vbartusevicius/knx-dali-gateway/hardware/releases/v3/README.md

# KNX-DALI gateway hardware v3 (1 DIN, two boards)

**Revision D (2026-10-22).** Changes against rev C (`59eea1f`, the first order): AUX-powered core (TRACO TMR 1-2411 U9 isolated converter, hand-fitted, plus TI TPS2121 U10 priority mux with the KNX buck as fallback); XIAO LM66100 U7 CE on VOUT (no USB back-feed); DALI TX clamp 2R, gate divider 4k7/10k, RX pull-up 4k7, buck EN 100k; enclosure with channels over the back-side diodes, board edge reliefs, backing ribs, C-shaped spring button tabs with front bumps and plungers, OLED supports beside the panel, longer DALI terminal slot; through-hole leads trimmed to 1.5 mm; a base right-wall recess over U9. Rev C boards and prints: follow [`hardware/docs/rework-rev-c.md`](../../docs/rework-rev-c.md) (pins in `rework/`). NCN5130 cluster re-placed to the datasheet layout rules (C1/C2/C3/C5/C15, L1).

**Hand-assembly revision (2026-11-11).** Every part is chosen for soldering with an iron:
- **Passives:** all 0805 or larger. The one exception is v3's three NCN5130 bus caps (C1 47 nF, C2 100 nF, C3 220 nF), which are 0603 so the chip's left side stays routable.
- **LEDs:** WS2812B-MINI-V3J with gull-wing legs (LCSC C22371519).
- **Crystal:** 2-pad 5032.
- **Core power path:** leaded parts (TLV803M U10, 2N7002 Q10, AO3401A Q9, B5819W D11) replace the VQFN TPS2121.
- **Still fine-pitch:** the NCN5130 (QFN-40; no leaded KNX transceiver exists: hot plate or hot air) and the LM66100 (SC-70-6, leaded).
- **Isolation:** DALI isolation is 5.5 mm (reinforced, IEC 60664-1 230 V OVC III PD2); SELV-AUX to SELV-KNX is 1 mm (functional).
- **Buttons:** left = SCROLL (plain bump), right = RESET (X bump).
- **USB service:** the XIAO is turned so its USB-C faces the main board's rail-side edge (x 38.1, 1.7 mm from the edge, nothing tall in the path). Lift main out of the base to plug in: with the board in the base the plug overmould does not fit under the right wall. test_usb_access.py keeps the plug path clear.
- `<board>/<board>_assembly.pdf`: hand-soldering guide. One page per populated side (the bottom mirrored, as seen from below), each part's body, reference and value, a red dot on pin 1, a black corner on hand-fitted parts and one colour per value. Large parts are dashed under the small ones. A values page lists quantity, side and references.

Generated by `HARDWARE_VARIANT=v3 python3 hardware/scripts/release.py v3` from
`hardware/layout/v3/`, with the same gates as v2: KiCad DRC 0 errors and 0
unrouted, every part orderable or hand-fit, every JLC part checked against
JLCPCB's part record, live stock and its EasyEDA footprint (pin for pin; the
placement file carries the fitted rotations and centres). CI
(`HARDWARE_VARIANT=v3`, `test_release_current.py`) fails as soon as either board
no longer matches this release.

| Board | Size | Layers | Thickness | Position in the case | Folder |
|---|---|---|---|---|---|
| **Breakaway Panel (`panel`)** | **55.6 x 78.0 mm** | **4** | **1.2 mm** | **Combined `main` + `ui` on one PCB with mouse-bite breakaway tabs (1 PCB + 1 PCBA order)** | **`panel/`** |
| Main (`main`) | 39.8 x 78.0 mm | 4 | 1.2 mm | vertical along the left side wall (two-sided): tall parts on the front (+x: KNX/AUX/DALI push-in pin strips, 470 uF SMD cap, 220 uH inductor, XIAO on 5 mm sockets with 5 V buck underneath, REC3-2415SRW/H2/A/CTRL, JP1, DALI bridge/pass transistor/optocouplers, UI FFC), low SMD parts on the back (-x, inside the THT solder-tail shadow: NCN5130 + crystal + passives, DALI TX/RX passives & transistors) | `main/` |
| UI (`ui`) | 13.8 x 40.5 mm | 4 | 1.2 mm | snapped into the cover protrusion: 0.96" 64x128 portrait SSD1312 OLED (QG-6428TSWCG02 / JLX12864OLED-S096W / NFP1312-15AY, 14.0 x 28.0 mm) soldered to the 14-pad 0.62 mm pitch footprint on the back with 3.3 V charge-pump passives, two Omron B3U-1000P buttons with 1.4 mm protruding caps, three RGB LEDs in a row below the buttons, 8-pin FFC to main | `ui/` |

A single 8-pin 0.5 mm **Type B (reverse / opposite-side contacts)** FFC cable (`SHOU HAN FFC-0.5-8P-50mm-B`, LCSC `C42416274`, 50 mm) connects `main` J4 to `ui` J1 (since both `J4` and `J1` are bottom-contact FFC connectors with Pin 1 on the same side, a Type B reverse cable connects Pin 1 `+3V3` to Pin 1 `+3V3`).

## Ordering at JLCPCB

1. **Recommended — Order as 1 Breakaway Panel (`panel/`):**
   - Upload `panel/panel_gerbers.zip` and select **4 layers, `1.2 mm` PCB Thickness** on JLCPCB's order page (note: JLCPCB's web form always defaults the thickness radio button to `1.6 mm` until you click **`1.2`**).
   - Enable **PCB Assembly (Both Sides)** and upload `panel/panel_bom_jlc.csv` + `panel/panel_cpl_jlc.csv`.
2. **Or Order as Separate Boards (`main/` and `ui/`):**
   - Upload `main/main_gerbers.zip` and `ui/ui_gerbers.zip` (4 layers, **1.2 mm**).
   - Upload `<board>_bom_jlc.csv` + `<board>_cpl_jlc.csv`.
3. `<board>_assembly_check.csv` (and `panel/panel_assembly_check.csv`) lists JLCPCB footprint, rotation and stock for
   every part.

## Ordering elsewhere (Aisler, PCBWay, Eurocircuits, ...)

Each board folder and `panel/` also holds fab-independent files:

- `<board>_odb.zip`: ODB++ (copper, drills, outline, netlist, component
  placement). Aisler's preferred upload; PCBWay and Eurocircuits accept it.
- `<board>_gerbers.zip`: Gerber X2 per layer, Excellon drills (plated and
  non-plated) and `<board>.d356`, the IPC-D-356 netlist for the electrical test.
- `<board>_bom.csv`: every part with value, footprint, manufacturer part number
  (LCSC number for reference), SMD/THT, and whether the assembler or you fit it.
- `<board>_cpl.csv`: placement of the assembled parts in KiCad's coordinates
  and rotations (the `_jlc` files use JLCPCB's rotations and are for JLCPCB only).

Order the stack-up, thickness and finish given above; check the assembler's
placement preview for the bottom-side and rotated parts as for JLCPCB.

## Ordering the parts yourself

For one complete gateway (all boards and hand-fit parts), in this folder:

- `order_lcsc.csv`: LCSC BOM tool (lcsc.com → BOM Tool, map **LCSC Part Number** and
  **Quantity**). Every board part plus the hand-fit parts LCSC sells; one line per LCSC number,
  designators as `board:ref`. Multiply the quantities for more gateways; LCSC rounds up to each
  part's minimum order.
- `order_elsewhere.csv`: the electronics LCSC does not sell (XIAO, REC3, converters, Phoenix pin
  strips and plugs, OLED, cable), with every Mouser / Digi-Key / TME number. A cell may list
  alternatives, e.g. `713-102010636 (or 713-113991254)`; buy one of them.
- `assembly_parts.csv`: everything not placed by the assembler, with a **Kind** column:
  `electronics` (the hand-fit parts above), `utility` (screws, foam pad, lead trimming) and
  `printed` (case parts). Utility and printed items are not in the order files; get them locally.

Not needed when JLCPCB assembles the boards: then order only the hand-fit lines.

## Hand-fitted parts (`<board>_hand_fit.csv`)

- `main` J1, J2: two **Phoenix Contact 1574200** (PST 1,0/2-5,75) pin strips on
  the bottom shoulder of `main` (pins pointing +x to the right). The red/black KNX
  plug (front) and the yellow/grey 20-32 V AUX plug (rear) go in from the right
  side into pockets sized for the WAGO 243-211 (11.5 x 10.2 x 10.2 mm, measured,
  0.3 mm clearance all round, a slot for the butterfly key on the lower wall)
  and sit on the strips, where their sockets meet the pins. Their wire entries
  face down, about 2.8 mm inside the open bottom of the pockets. With the
  11.5 mm plug, about 1 mm of it stands out of the case's right side: leave
  that gap to the next device on the rail.
- `main` J3: **WAGO 2086-1202/700-000/997-604**, the 2-pole 3.5 mm SMD DALI
  push-in terminal. Hand-solder it (JLCPCB has none in stock; Digi-Key
  `2946-2086-1202/700-000/997-604CT-ND`). Its wire entries and both release
  buttons are in the face that sits in the top-wall opening: press a button
  with a 2-2.5 mm flat screwdriver to release a wire. Strip 8-9 mm,
  0.14-1.5 mm2. Rated 160 V (overvoltage cat. III) / 320 V (cat. II): fine for
  DALI, not for a 230 V circuit.
- `main` U3: RECOM **REC3-2415SRW/H2/A/CTRL** (or **REC3-2415SRW/H4/A/M/CTRL**, DIP-24, A pinning with pin 1 CTRL; clip unused pins 3 and 11 flush before soldering; or Mean Well **SCWN06B-15** / **SCW03B-15** if software PSU shut-off is not needed).
- `main` U8: Seeed **XIAO ESP32C6 Pre-Soldered (SKU 102010636)** in two 1x7
  5.0 mm female headers (`assembly_parts.csv`).

Legend (3 mm letters, 0.6 mm deep, so a powder print keeps them):
- Right side of the base, next to the connectors: `KNX` above the front plug
  pocket, `AUX` above the rear one, `DALI` level with the DALI terminal at the
  top. They are engraved into `base.stl`, so every print has them.
- Front: no text. The left button (SCROLL: page / hold 5 s WiFi setup) has a
  plain round bump, the right one (RESET: tap reboot / hold 5 s KNX
  programming mode) has an X recessed 0.35 mm into its bump; both held 10 s
  is a factory reset. The three LEDs are unmarked; from left to right they are
  STATUS, KNX and DALI. There is no `cover_embossed.stl` on v3.

Off-board parts (including the **0.96" 64x128 SSD1312** 14-pin `0.62 mm`-pitch
OLED `QG-6428TSWCG02` / `NFP1312-15AY`, whose `12.0 mm` flex tail folds through
the `9.8 mm` top notch on `ui` and solders onto `ui` J2) are in `assembly_parts.csv`.
