vbartusevicius/knx-dali-gateway/hardware/docs/review-2026-10-23.md

# Pre-manufacturing review, 2026-10-23

Scope: v2 rev C and v3 rev D at `f3ccb1e`. That is the state after the 2026-10-22 review: AUX core
supply (U9 TMR 1-2411, U10 TPS2121) and the rev D NCN5130 placement. Nothing from these sources has
been ordered yet. Boards and prints already made from `59eea1f` are covered by
[rework-rev-c.md](rework-rev-c.md). No finding below adds a rework step for them (see the last section).

Status: **fixed** = changed in the sources; **open** = not fixed yet. Where possible it is pinned by a
strict-xfail test that fails as soon as the fix lands, so the marker has to be removed;
**accepted** = known and tolerated; **bench** = only a measurement can settle it.

## Automated checks

| Check | v2 | v3 |
|---|---|---|
| `build.py --eda` (netlists, sync, routing check, renders) | pass | pass |
| `build.py --cad` (enclosure, fit, legend, renders) | pass | pass |
| EDA suite (`hardware/tests`, `test_fit`, `test_ui_stackup`, `test_board_stack`) | 186 passed, 2 skipped | 163 passed, 4 skipped |
| CAD suite (`test_enclosure_probe`, `test_enclosure_solids`, `test_front_legend`, `test_step_geometry`) | 49 passed, 1 skipped | 43 passed, 5 skipped |
| `ruff` lint | pass | pass |
| DRC errors / unrouted | 0 / 0 | 0 / 0 |

The skips are by design (no AUX copper on the interface board; the v3 pad has no thermal vias, L2; the
v3 legend has no bracket).

Running `build.py --eda` on unchanged sources rewrote every stored `.kicad_pcb`. Footprints, positions,
tracks, vias and zones were identical; only UUIDs and order changed. `test_release_current` then
failed against the committed release (R1 below). The suites above ran on the committed layouts.

## Electrical

| # | Finding | Evidence | Status |
|---|---|---|---|
| E12 | **The core rail can collapse during the TPS2121 switchover.** CP2 is grounded, so the mux runs in plain priority mode. The guaranteed switchover time is then tSW = 100 µs max; the 5 µs fast switchover (tFSW) needs CP2 ≥ VREF. A WiFi TX peak needs about 298 mA at 5 V: 354 mA chip at 21 dBm, plus OLED and optos, through the 88 % XIAO buck, plus LEDs. That is above the TMR 1's 240 mA minimum current limit, and its overload mode is foldback. So TX bursts drag AUX below the PR1 threshold (3.9 V worst case) and hand over to KNX. AUX unplugged during a burst does the same. The derated 10 µF ceramics on +5V/+5V_XIAO then fall to about 1.1 V within 100 µs, so the ESP32-C6 browns out. The 2026-10-22 note "switches within microseconds" holds only with CP2 ≥ VREF. AUX-only operation (KNX bus down) cannot carry TX peaks at all with a 1 W converter. | TPS2121 SLVSEA3F §7.5 tSW/tFSW, §9.3.7, table 9-3; TMR 1 datasheet p.2 (current limit 120 % min, foldback); ESP32-C6 datasheet v1.5 table 5-7; `test_circuit_physics::test_core_rail_rides_through_the_mux_switchover` (strict xfail; with `--runxfail`: 1.12 V) | TX peaks fixed: v3 TMR 2411, v2 TRN 3-2411 (follow-ups below). AUX hot-unplug during TX still open (C23 100 µF: 3.08 V worst case) |
| E13 | **TX active half-bits are stretched by about 38 µs (typical).** The TX opto runs saturated: 6 mA LED, about 1 mA collector. The TLP383 turn-off at IF 16 mA / RL 1.9 kΩ is 28 µs typical, and the gate discharge adds about 10 µs. The transmitter window allows +16 µs (433 − 417). The existing `test_tx_gate_turns_off_within_the_half_bit_tolerance` passes only because it gives the opto an unverified 4 µs share. Firmware has no edge trim. | TLP383 datasheet (2019-12-16) table 10; `Timing.hpp` tx_half 400–433; `test_tx_active_half_bit_stays_inside_the_transmitter_window` (strict xfail; 38 µs) | open: firmware trim of active half-bits in the RMT encoder (about 20–35 µs, set from the bench measurement); then set `FIRMWARE_TX_ACTIVE_TRIM_S` and remove the marker |
| E14 | **Losing KNX switches the internal DALI supply off, even when AUX powers the core.** SAVEB is pulled up to `+3V3_TRX`, the NCN's own rail. With KNX absent it reads low; the ESP pull-up only reaches about 0.6 V against 10 kΩ to 0 V. `KnxDevice::update_led` then calls `NetworkServices::emergency_power_down()`, which sets `DALI_SUPPLY_OFF` high and skips `DaliPsuMonitor` (short detection) completely. With the AUX core this turns a KNX bus outage into a DALI outage, against the "DALI continues" requirement. Even in KNX-only operation it gains nothing: the REC3 runs from AUX, and the supply-off opto LED adds 6.4 mA to the dying 3.3 V rail. Hardware cannot make SAVEB read high with the NCN unpowered (its pin clamps to its VDD). | `knx.py` (R SAVEB to +3V3_TRX); `KnxDevice.cpp:194-212`; `NetworkServices.cpp:881-884` | open (firmware): on SAVEB low only log and flush; keep the PSU monitor and the supply state |
| E15 | With KNX absent and AUX present (new with the AUX core), the idle-high UART TX (GPIO16) feeds the unpowered NCN5130 SDI clamp through the 1 kΩ (up to about 2.7 mA), together with the SAVEB pull-up. `+3V3_TRX` is partly back-powered. The NCN power-on reset when the bus returns is then not specified. KNX_TXD (NCN SDO) floats into the UART RX. | `knx.py` R KNX_RXD 1k; NCN5130 has no Ioff spec | open (firmware): with SAVEB low, set GPIO16 to input or low and ignore UART RX; bench: measure `+3V3_TRX` and the NCN restart |
| E8 | (update) The sustained-short risk with the MCU unpowered is now reduced. With AUX present the TMR 1 powers the MCU, so `DaliPsuMonitor` can run whenever the REC3 runs. Today, though, it is disabled exactly when KNX is absent (E14). | — | open until E14 is fixed; hardware foldback no longer the only option |
| E16 | DALI RX threshold. Worst case, the "bus high" detection needs Vz 5.88 + VF 1.4 + limiter 0.95 + bridge 1.4 ≈ 9.6 V. That uses the test's conservative CTR 1.0, which forces the LED to the 0.81 mA limit. The spec point is 9.5 V. With typical values about 8.5 V. The low side is fine: at 6.5 V the zener sees about 3.7 V, so there is no LED current. | MMSZ5V6 ±5 % at 5 mA; TLP383 VF 1.1–1.4 V at 10 mA | bench: sweep the bus 6–10 V and record the switching point |
| E17 | REC3 load during DALI transmission. The internal limiter allows 167–227 mA, above the REC3's 200 mA rating, during every active low. Its overload behaviour at 227 mA (SCP, auto recovery) is not documented as a number. | `test_tx_clamp_lets_the_bus_supply_set_the_low_level` (limiter max) | bench: watch the 15 V rail during a long frame and a 1.3 ms collision break |

### Fix proposal for E12 (needs a layout change on both variants)

1. **Fast switchover (XREF).** CP2 gets a divider from `+5V_BUCK`: R27 30k / R28 10k gives 1.20–1.27 V, which is ≥ VREF 1.10 max and enables tFSW = 5 µs. Change R24 from 30k to 24k: PR1 is then ≥ 1.41 V at AUX 4.95 V, above CP2. Behaviour: AUX hands over below about 4.1–4.3 V. With KNX absent, CP2 = 0 and PR1 is above VREF, so IN1 (AUX) is selected. With AUX absent, IN2 (KNX) is selected. With this alone the test computes a 3.75 V minimum (pass).
2. **Bulk on the mux output.** C23 10 µF/0603 → 47–100 µF (1206 X5R, or polymer). This gives margin for the repeated handovers during TX bursts (TMR foldback/recovery chatter). The TMR 1 allows 1680 µF.
3. **Source status.** TPS2121 ST is open drain, high = IN1. Connect it to the spare D3/GPIO21 with a 10k pull-up to 3V3, instead of GND. Firmware can then pick `wifi_power_save`: continuous on AUX, modem sleep on KNX (E6). It can also tell a KNX outage from imminent core loss (E14).
4. **AUX-only with WiFi.** Option a: TMR 2411 (2 W, 400 mA, SIP-8 21.8 × 9.1 × 11.2 mm, 1000 µF max load); this needs new placement in both cases. Option b: limit the WiFi TX power in firmware while ST reports AUX without KNX, then measure. User decision.

New parts get new fixed references (R27, R28), so nothing renumbers. Freerouting is chaotic: expect re-placement around U10 (AGENTS.md).

### Follow-up (user decision, same day): 2 W converter on v3 instead of the switching change

The user chose option 4a over items 1–3 for v3: a 2 W converter that carries the WiFi TX peaks itself,
in the free space of the front protrusion between the main board edge and the UI board.

- **Part:** U9 is now a TRACO TMR 2411. Ratings: 18–36 V in, 5 V, 400 mA, 1.6 kVDC functional, 1000 µF max load, Remote pin 3 left open (= on). Package SIP-8, 21.8 × 9.1 × 11.2 mm. Stock: Mouser 495-TMR-2411 (447 pcs, USD 15), Digi-Key 1951-2741-ND (1241 pcs, USD 17.24). The TMR 3-2411 (3 W, 600 mA) uses the same package and pins.
- **Footprint:** `Converter_DCDC_TRACO_TMR2_SIP8`. The outline puts the pin row 3.5 mm from one long face and 5.6 mm from the other, but does not say which face is marked. Fab and courtyard therefore cover 5.6 mm on both sides, and the placement fits either orientation.
- **Physics:** 298 mA TX peak at 5 V against 400 mA. New test `test_aux_converter_carries_the_wifi_tx_peak` passes on v3; it is a strict xfail on v2, which keeps the TMR 1-2411.
- **Layout, v3 main:**
  - The board gets a tongue: outline x −10.3…0, y 18.3…59.7. It reaches enclosure z 52.2, which is 0.2 mm inside the protrusion walls and 0.5 mm behind the UI board's parts.
  - U9 stands on the tongue's upper half, pin 1 at the top, pin row at x −4.55. Its body (x −10.15…1.05) stays clear of the UI board's FFC exit above UI J1.
  - An AUX corridor brings AUX_P/GNDA to U9: along the bottom edge (y < 3.4), up the front edge (x < 1.5), across the tongue's bottom and along its outer edge. 2 mm keep-outs separate it from SELV-KNX.
  - U9's output pins (6/7) connect down into the KNX zone.
  - A 6 mm keep-out (x −3.8…2.4, y 42…63.5) separates the tongue copper from DALI.
  - To clear these keep-outs: D1/D2 moved to x 7.1; Q1 moved +1.4 mm; D8, R16, R17, Q3, R18, C18 and D9 moved +0.4…1.5 mm. The old rear-bottom U9 corner is empty.
  - Freerouting: 0 unrouted, DRC 0. Isolation tests pass on the routed copper.
- **Enclosure:** U9's top (11.7 mm max) reaches x 7.5. A new `protrusion_part_reliefs()` cuts a 0.4 mm channel in the cover's right protrusion wall, open towards the base. The base's right wall and the cover lips get local recesses (existing code). The body ends 0.34 mm below the UI snap hook and 0.9 mm behind the UI parts. All solid, probe and fit tests pass.
- **Still open:** with CP2 grounded, unplugging AUX during a TX burst still takes up to 100 µs to switch over (`test_core_rail_rides_through_the_mux_switchover` stays a strict xfail).

### Follow-up 2 (same day): v3 tongue cut back, C23, v2 converter

- **v3 tongue:** below U9 only a 1.4 mm strip remains (outline x −1.4…0, y 18.3…37.3), which frees the protrusion under U9 for the UI cable. The AUX corridor now runs up that strip and along the tongue's lower edge (y 37.6–38.4) to its outer edge. 2 mm keep-outs: x 0…1.7 beside the strip, y 38.4…40.4 above the lower edge. To clear them: C4 turned 90° (VFILT pad from x 0.8 to 5.6), L1 +0.8 mm in y, C7 +0.1 mm, R14 moved to (4.4, 36.9), C21 to the back at (1.5, 41.0). NCN5130 layout rules, isolation, DRC 0 / unrouted 0.
- **C23:** 100 µF 6.3 V X5R 1206 (Samsung CL31A107MQHNNNE, LCSC C15008, basic part, 1.9 M in stock) on both variants. With about 30 % of the capacitance left at 5 V (series curve estimate), the worst case (AUX lost at a 298 mA TX peak, 100 µs switchover) dips to 3.08 V, against 1.12 V with 10 µF. The 3.5 V target is still missed, so the test stays a strict xfail. At the continuous-RX load (115 mA) the dip is about 0.3 V.
- **v2 converter:** the TMR 2411 does not fit v2.
  - The 7.7 mm strip on the back is too narrow for its 9.1 mm body.
  - Under the interface board there is 11.0 mm, against an 11.7 mm maximum height.
  - The free-looking top area on the front sits over the REC3 (U3, back, y 38–70), so through-hole pins there would land on its body. It is also SELV-AUX/DALI copper, far from the KNX zone that the output must reach.

  U9 on v2 is therefore a TRACO **TRN 3-2411** (3 W, 5 V 600 mA, 18–36 V, 1.6 kVDC functional, current limit 180 % typ, 2200 µF max load). Its SIP is 11.9 × 7.7 × 11.0 mm with pins 1 −Vin, 2 +Vin, 3 +Vout, 5 −Vout. It stands in the old strip on the back (pin row y 33.6), with Fab/courtyard covering 4.0 mm on both sides of the pin row. Pins 2 (AUX) and 3 (KNX) are only 2.8 mm apart, so the AUX tracks leave upwards and the KNX tracks downwards. A 1.0 × 3.0 mm board slot between those pins lengthens the creepage path past 2 mm. Stock: Newark 47AC2160 (37), LCSC C5987491 (9), about USD 22, 24-week factory lead time. Check stock before ordering.
- **Tooling bug found (fixed):** the generated DRC rules tried to exempt an isolator's own pins with `A.Reference == 'Ux'`. KiCad evaluates creepage per net pair, so no item condition (`Reference`, `memberOfFootprint`) ever matches, and the exemption never worked. Previous boards never needed it. `layout.dru_rules` no longer pretends to exempt anything. `test_drc_creepage::test_slot_between_isolator_pins_meets_creepage` shows that a slot clears the violation and a rule cannot. `test_isolation.py` keeps its own same-isolator exemption.

## Datasheet cross-checks (parts changed since `59eea1f`)

| Part | Checked | Result |
|---|---|---|
| U9 TRACO TMR 1-2411 | Datasheet rev. 2026-04-15 p.1–4 | 18–36 V, 5 V ±1 %, 200 mA, UVLO 17.5 V max, surge 50 V/1 s, 1680 µF max load, no minimum load, current limit 120 % min with foldback, functional isolation 1.5 kVDC/60 s. Pinout 1 −Vin, 2 +Vin, 4 +Vout, 6 −Vout matches `pinouts.yaml` and the footprint. Pin 1 is 2.15 mm from the end and the pin row 2.5 mm from the back face. From the projection, the marked face is 5.12 mm from the pin row, which matches the footprint's +y side. Body 17.0 × 7.62 × 11.0 (±0.5) and pins 3.2 match `package_heights.yaml` (11.5 / 3.7). Its 0.3 W loss is fine in the case. |
| U10 TI TPS2121RUXR | SLVSEA3F | Pin map 1/8 OUT, 2 IN2, 3 CP2, 4 OV2, 5 OV1, 6 PR1, 7 IN1, 9 ST, 10 ILM, 11 SS, 12 GND matches the netlist. ST/OV1/OV2/CP2 to GND are allowed ("connect to GND if not required"). ILM: 65.2 / 100^0.861 = 1.24 A. SS 100 nF: 780 V/s. Abs max 24 V, inputs at 5 V. **CP2 = GND means tSW 100 µs (E12).** |
| TLP383(D4BLLTL,E) | Datasheet 2019-12-16 | VF 1.1–1.4 V at 10 mA; saturated CTR (1 mA, 0.4 V) 30 % min for GB, none listed for BL; switching ton 0.95 / ts 14 / toff 28 µs (16 mA, 1.9 kΩ) and 7.5 / 7 / 30 µs (1.6 mA, 4.7 kΩ). The extracted rank table cannot be mapped to BLL with certainty, so the `OPTO_CTR_MIN = 1.0` constant stays. The turn-off figures are E13. |
| ESP32-C6 | Datasheet v1.5 table 5-7 | TX peak 354 mA (802.11b, 21 dBm); VDD 3.0–3.6 V. Constant added to the tests. |

## Stock and price (live JLCPCB `jlc_parts.py stock --boards 5`, 2026-10-23)

| | v2 | v3 |
|---|---|---|
| JLC-assembled parts per board | USD 15.97 | USD 13.00 |
| Extended part types (feeder fee, about USD 3 each per order) | 35 (≈ USD 105) | 32 (≈ USD 96) |
| Short for 5 boards | none | none |
| Under 100 in stock | — | KH-FPC0.5-H1.2SMT-8P-QCHF (C48532769): 31, 2 per board |

Other notable lines: PTS645SL70 (v2) 123; KH-2.54FH-1X3P (v2) 252; MJD45H11 405; SMNR4012-4R7MT 862;
NCN5130 1884 at USD 5.43; TPS2121 25521 at USD 0.92; TLP383 2608.

Hand-fitted parts (web search, not a live distributor API):
- TMR 1-2411: TME 253 pcs at USD 9.27 (symbol `TMR1-2411`), Newark 140, element14 140, LCSC 5. **Fixed:** the assembly list said `tme: '-'` (`gen_circuits.py`, both `assembly_parts.yaml`, both release CSVs).
- REC3-2415SRW/H2/A/CTRL: about USD 17.5, brokers list 120–180 pcs. Check Digi-Key 945-1695-5-ND before ordering.
- XIAO ESP32C6 Pre-Soldered (102010636): about USD 8, Digi-Key and several distributors in stock.

| # | Finding | Status |
|---|---|---|
| S1 | v3 assembly text still said the AUX plug is "for the internal DALI supply only". It now also feeds U9. | fixed (generator, yaml, release CSV) |

## Mechanics (by hand)

Fit drawings and renders were checked for v2 and v3. All solid/probe tests pass; the 2026-10-22 items M1–M9
are fixed in the sources. No new interference was found. The v3 U9 sits beside the AUX plug, and the
plug body and pull direction are clear. The U9 body orientation was checked against the datasheet
projection (table above). The open bench items from 2026-10-22 still apply: FFC Type B fold mock-up,
KF142R release access, XIAO pin seating in the 5.0 mm sockets, PST strip versus the v3 wall.

## Process

| # | Finding | Status |
|---|---|---|
| R1 | `layout.sync` is not byte-reproducible: UUIDs and order change on every `--eda` run without geometric change. A routine rebuild therefore always breaks `test_release_holds_the_stored_layout` and creates 37k-line diffs. | open: keep footprint UUIDs from the stored board in `sync`, or compare releases on geometry |

## Physics answers (skill §4)

- **DALI current, internal supply:** JP1 fitted, limited by Q-pass/R 3R3 to 167–227 mA. **External supply:** limited by the supply (≤ 250 mA). The TX clamp at 275–350 mA never decides, and every TX path pulls below 4.5 V (`test_tx_low_level_at_250ma`). **Unpowered MCU:** the TX opto is off, so the bus is released. A sustained short is held by firmware only (E8/E14).
- **Opto edges:** TX +38 µs typical on active half-bits (E13). RX: bus falling edges are seen about 30 µs late and rising edges about 7.5 µs late, so received lows look about 22 µs shorter. That stays inside the 333–500 µs window for a 400–433 µs sender.
- **KNX:** VFILT ≥ 16.75 V at a 21 V bus and 40 mA. Buck on ≤ 15.7 V, off ≥ 10.1 V (tests). Modem-sleep WiFi down to a 16.3 V bus; continuous WiFi from 22.7 V. A TX burst on KNX-only power draws about 72 mA net from the 470 µF: 0.3 V droop per 2 ms. SAVEB warning, estimated with the firmware's 14 V trigger down to the buck's 10.1 V off point: about 50 ms at modem-sleep load and about 12 ms during TX. Bench-check the NVS flush time.
- **Inputs:** ADC ladder 2.2 / 1.65 / 1.32 V within the ESP32-C6 ADC (12 dB). SAVEB is low whenever KNX is off (E14). DALI_RX idles low with bus power and high without. I2C 4k7 in parallel with the module pull-ups is ≤ 1.4 mA. LED data at 3.3 V meets the AHCT VIH of 2.0 V.
- **Thermal (closed case):** REC3 about 0.4 W, TMR 1 ≤ 0.3 W, NCN5130 0.2 W, Q-pass 0.05 W idle (2–3 W only during active lows). In total about 1 W, which is moderate even in 1M.

## Bench items (added to the 2026-10-22 list)

- E12: with AUX and KNX both connected and WiFi TX at full power, scope +5V and the XIAO 5V pin. Unplug AUX during traffic. Count the brownout resets.
- E13: scope the bus during a forward frame and measure the active half-bit length; set the firmware trim.
- E14/E15: AUX on, KNX unplugged. Check that the DALI supply stays on (after the firmware fix), measure `+3V3_TRX`, then reconnect KNX and confirm the NCN5130 comes back (U_Reset response).
- E16: RX switching point versus bus voltage. E17: REC3 15 V rail during the collision break.
- v3 TMR 2411: note which long face of the real part is 3.5 mm from the pins, then tighten the footprint outline to it. Check its seating and the cover relief over its top.
- v3 FFC: the fold above UI J1 now has 2.6 mm (enclosure y 36.7 → 39.3) before U9's lower end; below U9 only the 1.4 mm AUX strip remains. Do the paper mock-up with U9 fitted.
- v2 buttons (now B3U-1000P with C-shaped cover tabs like v3): the tab arms are about 7 mm long, softer than v3's. Check press force, travel and return on the first print.
- v2 TRN 3-2411: check the seating between the J6 tails and the REC3 body (0.85 mm to the tail tips). The slot sits under the converter body.

## Ordered hardware (`59eea1f`, v2 rev B / v3 rev C)

Those boards have no U9/U10 (KNX-only core), so E12 does not apply. E13–E16 are firmware or bench
items that apply equally. E14 on those boards only costs the 6.4 mA opto current while the core is
already dying. No new rework steps; rework-rev-c.md is unchanged.
