vbartusevicius/knx-dali-gateway/hardware/docs/review-2026-10-22.md

# Pre-manufacturing review, 2026-10-22

Scope: v2 and v3 (v1 dropped the same day). Reviewed against the `59eea1f` sources, which are what was
ordered (PCBA and prints): circuits, layouts, enclosure, part data, datasheets and stock.
How to repeat the review: `.claude/skills/hardware-review/SKILL.md`. How to fix boards and prints
already made from `59eea1f`: [rework-rev-c.md](rework-rev-c.md).

Status: **fixed** = changed in the sources and covered by a test that failed before the change;
**rework** = the ordered hardware needs the hand step in rework-rev-c.md; **open** = not fixed yet.

## Electrical (shared blocks, v2 and v3)

| # | Finding | Evidence | Status |
|---|---|---|---|
| E1 | The DALI TX current clamp (3R3 + BC847) was about 167–227 mA. That is below the 250 mA a DALI transmitter must sink (IEC 62386-101) and about equal to the internal supply's own 3R3 limiter. When the clamp is the lower limit, the bus stays high (no transmission) and the SOT-23 MOSFET dissipates 2–3 W. With external 250 mA supplies this always happens. | `test_circuit_physics::test_tx_clamp_lets_the_bus_supply_set_the_low_level` (failed at 167 mA) | fixed: 2R (C17942), clamp 275–350 mA; rework |
| E2 | The TX gate discharged only through 100k (IRLML0060 Ciss 290 pF, Qgd 1.3 nC). About 110 µs release delay stretched active half-bits from 417 µs to about 530 µs, outside the 333–500 µs receiver window and the 400–433 µs transmitter window. | `test_tx_gate_turns_off_within_the_half_bit_tolerance` (failed at 113 µs) | fixed: 4k7 series / 10k pull-down, about 9 µs; rework |
| E3 | A gate divider that only speeds up turn-off would leave V_GS at about 4.2 V after a 1.3 ms collision break at a 9.5 V bus. | `test_tx_gate_drive_holds_through_the_longest_active_period` | fixed: 4k7/10k gives 5.6 V |
| E4 | The DALI RX pull-up of 10k keeps the TLP383 deep in saturation, so rising DALI_RX edges lag by tens of µs. Firmware does not compensate. | estimate; `test_rx_optocoupler_saturates_its_pull_up` | fixed: 4k7; rework; bench measurement still required |
| E5 | SCT2400 EN divider 120k/10k (with the 480k internal pull-down): turn-on up to 18.5 V, while VFILT is 16.75 V at a 21 V KNX bus. The 5 V rail may never start on a long or heavily loaded line. | `test_buck_starts_at_the_lowest_knx_bus_voltage` (failed at 18.55 V) | fixed: 100k, on 15.7 V max / off 10.1 V min; rework optional |
| E6 | KNX power budget (corrected: the XIAO's 3.3 V regulator is an SGM6029C buck, not an LDO). Modem-sleep WiFi needs at least 16.3 V of bus, so it works over the whole KNX range. Continuous WiFi RX (`wifi_power_save` off) needs at least 22.7 V. Earlier tests used 20 V × 40 mA and ignored the coupler drop and the NCN's own current. | `test_knx_power_budget_*` | by design: power save stays on below a 24 V bus; bench measurement required |
| E7 | REC3-2415SRW/H2 isolation is functional: 2 kVDC for 1 s, 1 kVAC for 1 min. | RECOM REC3-RW datasheet | accepted by the user: no medical/reinforced REM3 |
| E8 | A sustained DALI short puts about 2.6 W into the MJD45H11. Firmware latches the supply off after 80 ms, but only while KNX powers the MCU (CTRL open = supply on). | DaliPsuMonitor | open: hardware foldback or thermal cut-off in a later spin |
| E9 | The ROM boot log on GPIO16 (UART0 TX) reaches the NCN5130 SDI at every reset. Firmware sends U_Reset afterwards. | ESP32-C6 boot behaviour | open: consider burning the UART_PRINT_CONTROL eFuse |
| E10 | The old tests in `test_power_logic.py` asserted constants ("TX limit 180–230 mA"), so they confirmed the bug. | — | fixed: replaced by netlist-driven `test_circuit_physics.py` |

## Power architecture: AUX-powered core (user decision, implemented on v3 rev D and v2 rev C)

The user made AUX the primary core supply, keeping the KNX fallback.

- **Circuit** (`hardware/circuits/blocks/core_power.py`):
  - The protected AUX rail (after the PTC, reverse diode and TVS) feeds a TRACO TMR 1-2411 (U9): 18-36 V in, 5 V ±1 % at 200 mA, 1.5 kVDC functional isolation between SELV-AUX and SELV-KNX.
  - A TI TPS2121 priority mux (U10) selects it as IN1 while its PR1 divider (30k/10k) is above the 1.10 V reference, i.e. AUX above 4.4 V. It falls back to the KNX buck (IN2, still 4.94 V) within microseconds.
  - Both inputs are reverse blocked, so the two 5 V sources never feed each other, whatever their tolerances.
  - Plain LM66100 ORing was rejected: TI's make-before-break ORing needs at least 250 mV between the sources, and the SCT2400 feedback tolerance (0.79-0.83 V) cannot guarantee that.
- **Why not AUX-only:** confirmed requirement. The gateway must still run and be ETS-programmable from red/black alone, e.g. with an external DALI PSU and no AUX. The NCN5130 cannot run from AUX.
- **Why isolated:** KNX TP must stay floating. A direct AUX- to KNX- tie would bypass the supply's bus choke (MDT STC unchoked U2) or tie the bus to an arbitrary 24 V supply.
- **Budget:**
  - The core draws about 115 mA at 5 V with continuous WiFi RX, within the converter's 200 mA (`test_aux_converter_carries_the_sustained_core_load`).
  - TX peaks above 200 mA drag the AUX rail below the switchover threshold, and the mux hands those peaks to the KNX path (470 µF store).
  - KNX-only: modem-sleep WiFi works down to a 16.3 V bus; continuous WiFi needs at least 22.7 V.
- **v3 placement:**
  - U9 stands in the rear-bottom corner beside the AUX input. Its pins 1/2 sit in the AUX zone and pins 4/6 in a new SELV-KNX island, with 2 mm keepouts.
  - F1, D3 and D4 moved. The XIAO moved 0.6 mm up.
  - The base's right wall has a 0.4 mm recess over U9's top (11.0 ±0.5 mm), generated from the part data (`front_part_reliefs`).
  - The protrusion tab the user suggested was not needed.
- **v2 placement (rev C):**
  - U9 stands on the back of v2 main, in the 7.7 mm strip between the interface socket tails (J6, y 28.4) and the REC3 body (y 38.0). Its 11.0 mm height fits the space under the board.
  - Pins 1/2 sit in a small SELV-AUX island joined to the AUX zone above; pins 4/6 sit in SELV-KNX, with 2 mm keepouts.
  - The supply-off optocoupler U4 moved to x 18.4 (with its slot), between U9 pin 6 and C4's leads. C4 moved 1 mm to make room.
  - The TPS2121 mux and its passives sit on the front, next to J4.
  - The interface board did not have to move.

| # | Finding | Evidence | Status |
|---|---|---|---|
| E11 | The XIAO's LM66100 (U7, both variants) had CE on GND. Per the datasheet (8.3.1/8.3.2) it is then an always-on switch, and only CE on VOUT gives reverse current blocking. USB VBUS on the XIAO 5V pin therefore back-feeds the core rail, the UI LEDs, and through the SCT2400's high-side body diode VFILT and C4. | LM66100 datasheet | fixed: CE on VOUT; rework optional (rework-rev-c.md step 2e) |

## Layout

| # | Finding | Evidence | Status |
|---|---|---|---|
| L1 | v3 main: NCN5130 datasheet layout rules were violated. The VBUS1–C1–CCP loop was 17 mm (5 mm wanted); the CAV and CEQ2 nets were 10.8 and 8.4 mm long; C5 sat 3.4 mm and C15 (VIN) 9.8 mm from their pins. The test only ever ran on v1. | `test_u1_routing.py` | fixed in v3 rev D: C1/C2/C3 re-placed under pins 4-8 (v2's arrangement), C5 at pin 40, C15 at pin 16, L1 1.2 mm closer (VSW1 under 10 mm), U1 pins 9/10 bridged; all rules pass. Rev C boards keep the old placement: bench-test KNX reception |
| L2 | v3 main's NCN5130 exposed pad has no thermal vias (deliberate, to keep the front side clear). About 0.2 W dissipation. | — | accepted |

## Mechanical

| # | Finding | Evidence | Status |
|---|---|---|---|
| M1 | v3: the back-side bridge D6 (DF-S, 2.6 mm) and D7/D8 (SMA, 2.44 mm) were modelled at 1.4–1.5 mm. They intersect the cover's left wall (only 2.0 mm of space): 61 and 11 mm³. | `test_modelled_heights_cover_the_package_maxima`, `test_case_misses_every_part_body` | fixed: heights default to `package_heights.yaml`, cover channels; rework (grind) |
| M2 | v3: THT solder tails stick out 2.3–3.1 mm (REC3 3.8 +0.5 pins, KF142R 3.5, sockets 3.0) into the 2.0 mm gap. | `test_solder_tails_clear_the_case` | fixed: assembly item "trim to 1.5 mm"; rework |
| M3 | v3: the main board (78.0 mm) was 0.2 mm larger than the base's inner height (77.8 mm), an interference fit before print tolerance. | `test_no_case_material_inside_a_board` | fixed: 0.2 mm edge reliefs; rework (scrape) |
| M4 | v3: the main board had no backing in -x. Plug insertion force went into back-side parts and solder joints. | `test_vertical_main_board_is_backed_by_the_case_over_its_area` | fixed: four 1.9 mm cover ribs; rework (2 mm pads) |
| M5 | v3: the B3U buttons (1.6 mm) sit 4.0 mm behind the front face, with no plunger. The stack-up still assumed 7 mm PTS645 actuators, so its test passed against geometry that does not exist. | `test_each_button_can_be_pressed_from_the_front` | fixed: C-shaped spring tabs in the cover front (left C, right mirrored C, both rooted on the middle bridge): 2.6 mm pad on a 2.0 mm arm, 0.45 mm slot, thinned to 0.7 mm; a rounded 2.0 mm bump on the front and a 1.4 mm plunger ending 0.1 mm above each actuator. About 2.6 % peak strain for the B3U's 0.15 mm travel; check on the print. Already printed covers: rework with printed pins |
| M6 | v3: the OLED "support rails" and both UI standoffs sat inside the 14 × 28 mm panel's own volume, so the panel could not seat. | `test_case_misses_every_part_body` ("OLED board") | fixed: rails removed, standoff blocks beside the panel, 4 mm foam pad; rework |
| M7 | v3: the KF142R body (Fab 12.7 mm, drawing N×5.08+2.6) is 0.9 mm longer than its courtyard, so the wire-entry slot left a 0.95 mm bridge the terminal hits. It also touches the shoulder plate. | `test_case_misses_every_part_body` | fixed: slot from the body outline + 0.2, plate relief; rework |
| M8 | v2: the cover's top screw tab overlaps the AUX terminal (J2) body by 0.75 mm, and the right locating lip overlaps the DALI terminal (J3) by 0.85 mm. | `test_case_misses_every_part_body` | fixed: tab centred at x 2.3 and 5 mm wide, lips notched at part bodies; rework |
| M9 | The probe tests sample point grids (3×3×3 per part, 9×9 per board), so thin overlaps passed. Part boxes used courtyards and hand-entered heights. | — | fixed: exact-solid `test_enclosure_solids.py`, Fab body outlines, datasheet heights |

## Verification items without a fix (bench)

- v3 FFC: Type B (opposite-side contacts) and pin 1 to pin 1 depend on the fold. Make a paper mock-up before plugging in (rework-rev-c.md step 5).
- KF142R release buttons: their orientation inside the closed case is not verified. Insert wires with ferrules; releasing one may need the case open.
- XIAO pre-soldered header pins (about 6 mm) in 5.0 mm low-profile sockets: check that they seat fully. The 11.0 mm stack is modelled on that assumption.
- PST 1,0 strip plastic height versus the v3 inner wall at x = -1.3 (0.1 mm gap modelled from a 2.8 mm "length" figure).
- DALI timing with the oscilloscope: TX half-bits 400–433 µs and RX skew. Firmware has no edge compensation yet.
- KNX power at the real bus voltage with WiFi active (E6). KNX reception on v3 rev C (L1).

## Stock (live JLCPCB, 2026-10-22)

KH-FPC0.5-H1.2SMT-8P-QCHF (C48532769, v3 FFC connector, 2 per set): 19–31 in stock. MJD45H11: about 400.
TLP383: 2600. NCN5130: 1900 at USD 5.43. Run `jlc_parts.py stock` before every order.
