vbartusevicius/knx-dali-gateway/hardware/releases/v3/enclosure/renders/back.png

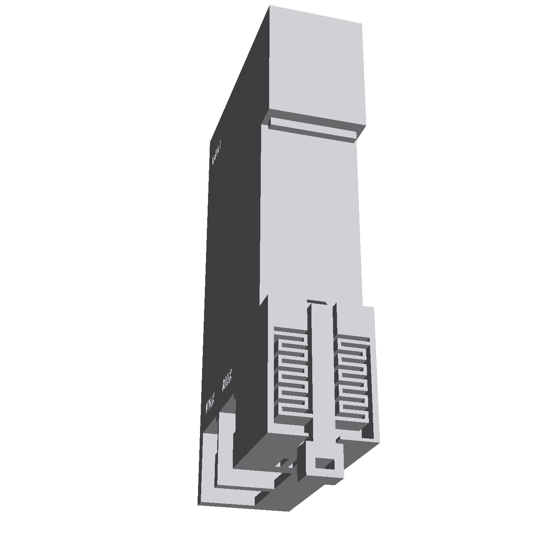
hardware/releases/v3/enclosure/renders/back.png
