vbartusevicius/knx-dali-gateway/hardware/releases/v3/enclosure/renders/exploded.png

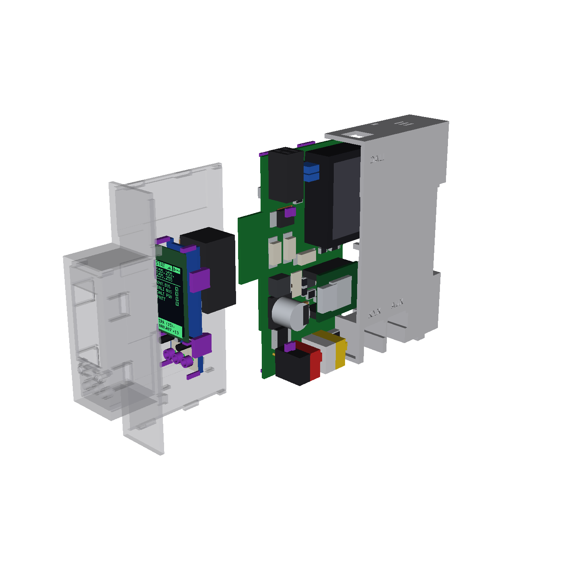
hardware/releases/v3/enclosure/renders/exploded.png
