vbartusevicius/knx-dali-gateway/hardware/releases/v3/enclosure/renders/front.png

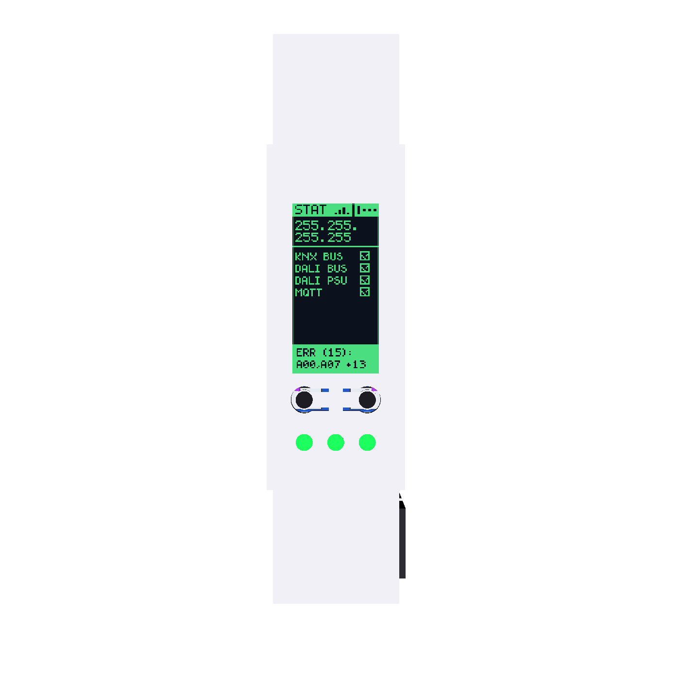
hardware/releases/v3/enclosure/renders/front.png
