vbartusevicius/knx-dali-gateway/hardware/releases/v3/enclosure/renders/inside.png

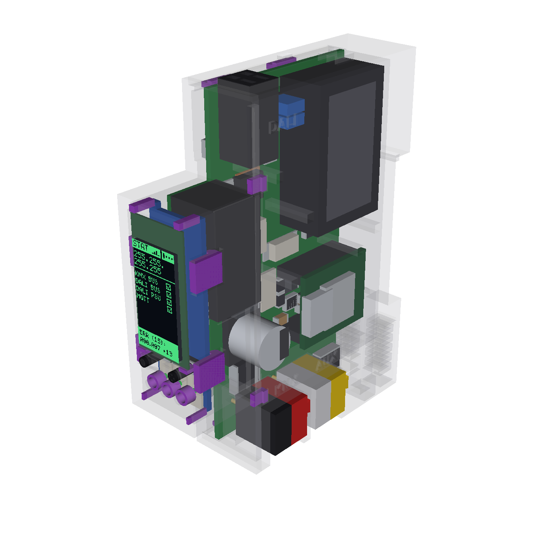
hardware/releases/v3/enclosure/renders/inside.png
