vbartusevicius/knx-dali-gateway/hardware/releases/v3/enclosure/renders/iso.png

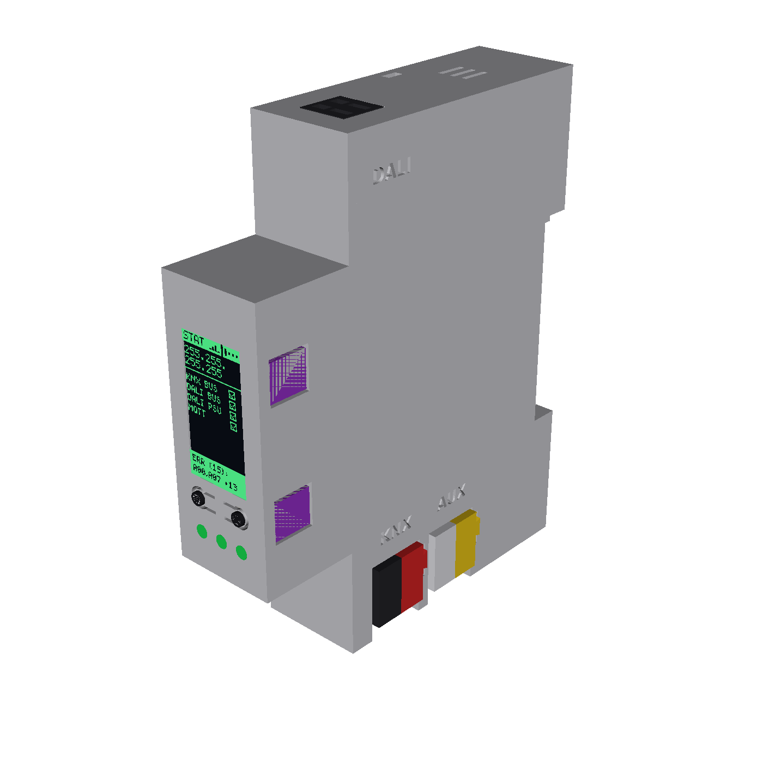
hardware/releases/v3/enclosure/renders/iso.png
