vbartusevicius/knx-dali-gateway/hardware/releases/v3/enclosure/renders/main_bottom.png

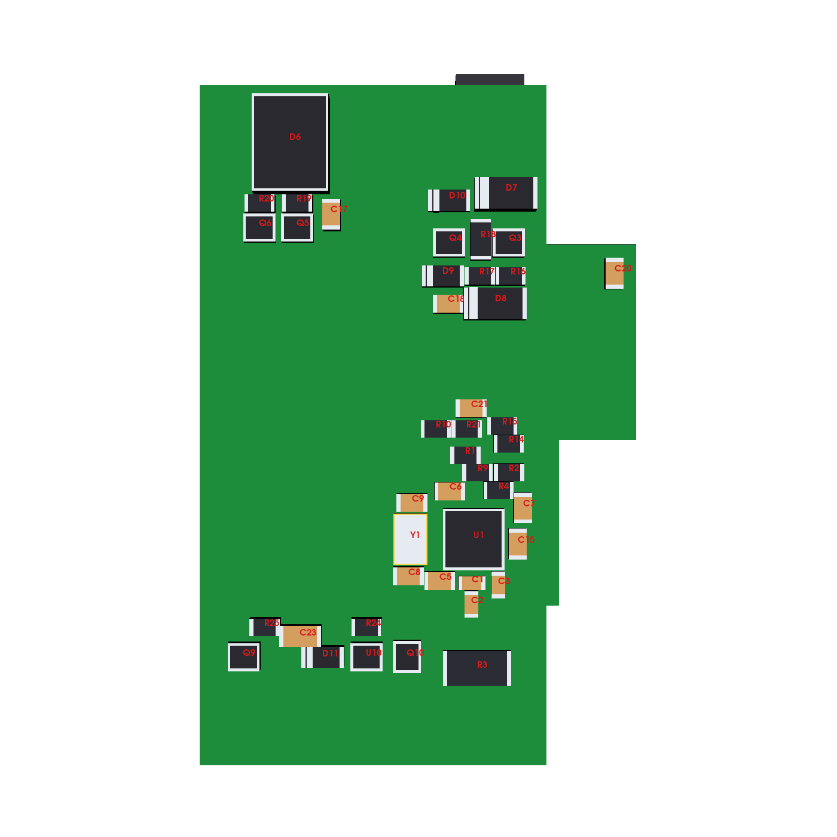
hardware/releases/v3/enclosure/renders/main_bottom.png
