vbartusevicius/knx-dali-gateway/hardware/releases/v3/enclosure/renders/main_top.png

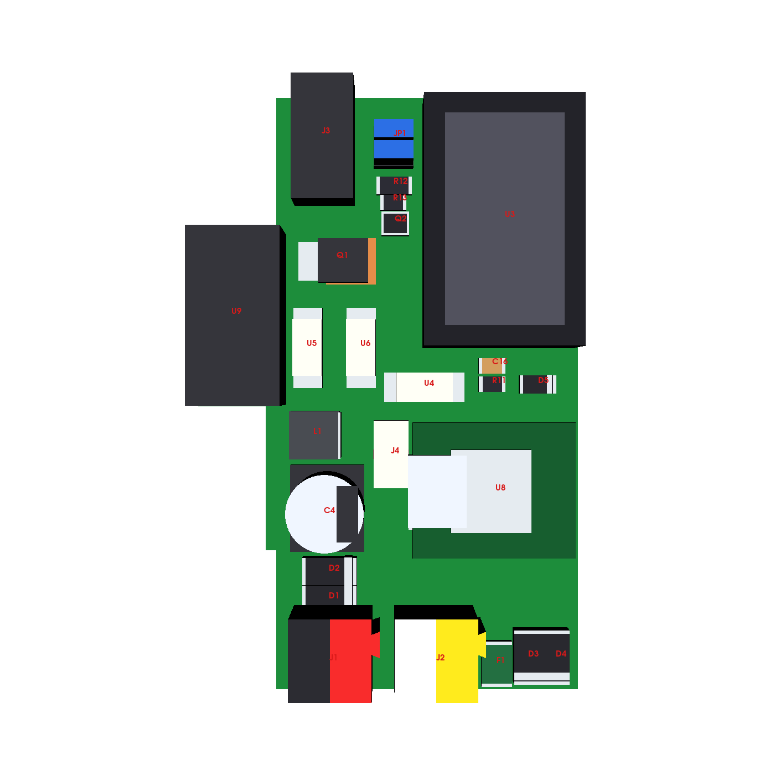
hardware/releases/v3/enclosure/renders/main_top.png
