vbartusevicius/knx-dali-gateway/hardware/releases/v3/enclosure/renders/section.png

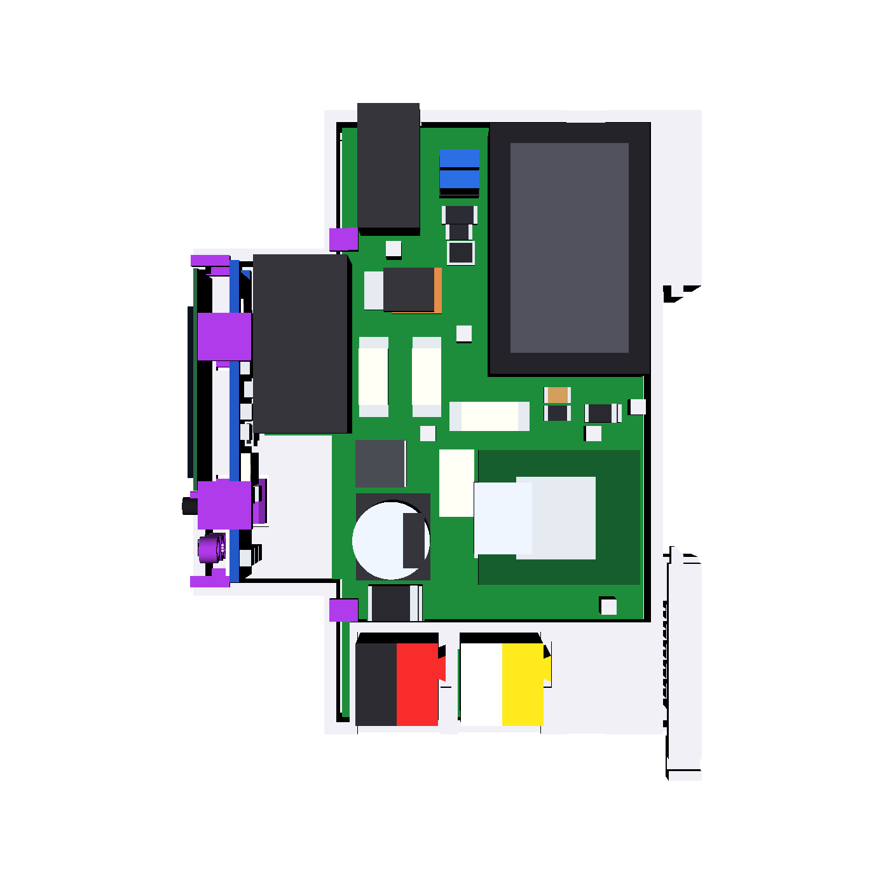
hardware/releases/v3/enclosure/renders/section.png
