vbartusevicius/knx-dali-gateway/hardware/releases/v3/enclosure/renders/ui_bottom.png

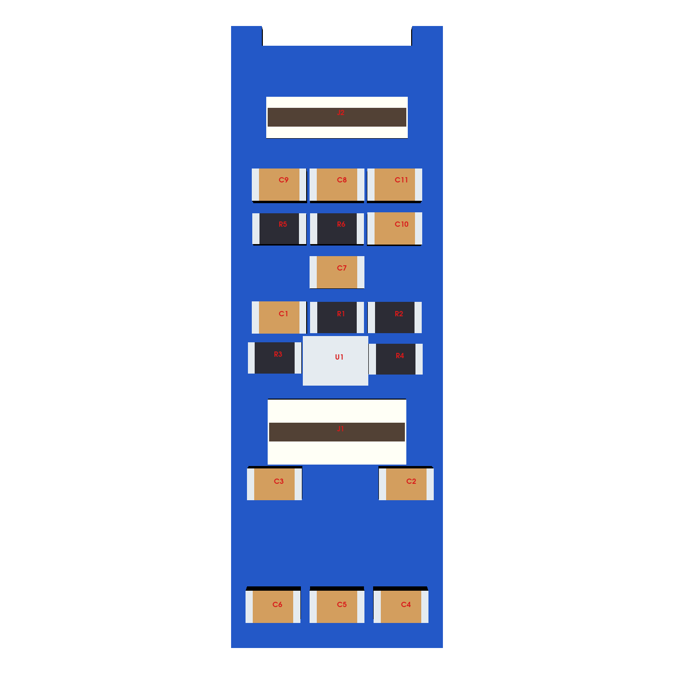
hardware/releases/v3/enclosure/renders/ui_bottom.png
