vbartusevicius/knx-dali-gateway/hardware/releases/v3/assembly_parts.csv

Item | Kind | Qty | Part | Mouser | DigiKey | TME | Description | Source
MCU module (hand-fitted into sockets) | electronics | 1 | Seeed Studio XIAO ESP32C6 Pre-Soldered (SKU 102010636) | 713-102010636 (or 713-113991254) | 1597-102010636-ND (or 1597-113991254-ND) | SEEED-113991254 | ESP32-C6 module with pre-soldered 2x7 pin headers; plugs into the two 5.0 mm female sockets (main U8) | Seeed Studio / Digi-Key / Mouser
XIAO sockets (hand-soldered) | electronics | 2 | 1x7 2.54 mm female header, 5.0 mm tall (CST 1165SDIG-07, LCSC C2886701; or Samtec SLW-107-01-G-S) | 200-SLW10701GS (or 855-M20-7890746) | SAM1111-07-ND (or 952-3228-ND) | - | 1x7 female header, 2.54 mm, 5.0 mm tall, soldered into main U8; the XIAO stays detachable | Mouser / Digi-Key / TME / LCSC
Isolated DALI DC-DC converter (hand-soldered) | electronics | 1 | RECOM REC3-2415SRW/H2/A/CTRL (or /H4/A/M/CTRL; or Mean Well SCWN06B-15 / SCW03B-15 without CTRL) | 919-REC3-2415SRWH2AC (or 709-SCW03B-15 / 709-SCWN06B-15) | 945-1695-5-ND (or 1866-4410-ND / 1866-4346-ND) | REC3-2415SRWZ/H4/A (or SCWN06B-15) | 24 V -> 15 V 3 W isolated DC-DC converter, DIP-24 A-pinning with pin 1 CTRL (main U3; clip unused pins 3 and 11 flush before soldering) | Digi-Key / Mouser / TME
AUX-to-core isolated DC-DC converter (hand-soldered) | electronics | 1 | TRACO TMR 2411 (18-36 V in, 5 V 400 mA, 1.6 kVDC, SIP-8; or TMR 3-2411, same package) | 495-TMR-2411 | 1951-2741-ND | - | powers the gateway core from the AUX input, ORed with the KNX buck (main U9) | Mouser / Digi-Key / TME
DALI push-in terminal (hand-soldered, SMD) | electronics | 1 | WAGO 2086-1202/700-000/997-604 | - | 2946-2086-1202/700-000/997-604CT-ND | - | 2-pole 3.5 mm SMD push-in terminal, push-buttons beside the wire entries, 0.14-1.5 mm2, strip 8-9 mm; solder onto main J3 (JLCPCB C3309855 has no stock) | Digi-Key / Farnell
KNX / AUX PCB pin strips (hand-soldered) | electronics | 2 | Phoenix Contact PST 1,0/ 2-5,75 R32 (1574200) | 651-1574200 | 277-1574200CT-ND | 1574200 | 2-pin 5.75 mm pitch Ø 1.0 mm pin strip soldered into main J1, main J2 | Phoenix Contact / Digi-Key / Mouser
KNX bus plug (red/black) | electronics | 1 | Phoenix Contact PTS 0,5/ 2-PH-5,75 BKRD (1574300) or WAGO 243-211 | 651-1574300 | 277-1574300-ND | WAGO 243-211 | red/black KNX bus push-in connector mating the PST 1,0/2-5,75 pin strip (main J1) | Phoenix Contact / Digi-Key / Mouser / WAGO
AUX 20-32 V plug (yellow/white) | electronics | 1 | Phoenix Contact PTS 0,5/ 2-PH-5,75 GY35YE (1574299) or WAGO 243-212 | 651-1574299 | 277-1574299-ND | WAGO 243-212 | yellow/grey auxiliary-voltage connector mating the rear PST 1,0/2-5,75 pin strip (main J2; 20-32 V for the internal DALI supply and the AUX core converter) | Phoenix Contact / Digi-Key / Mouser / WAGO
OLED display (14-pin 0.62 mm solder FPC) | electronics | 1 | QG-6428TSWCG02 / JLX12864OLED-S096W / NFP1312-15AY (0.96 in 64x128 SSD1312 I2C) | - | - | - | 0.96 in 64x128 portrait SSD1312 I2C OLED (14.0 x 28.0 x 1.22 mm); 12.0 mm x 9.3 mm flex tail folds through the 9.8 mm top notch on UI and solders directly onto the 14-pad 0.62 mm pitch footprint ui J2 | AliExpress (1005003749452625) / Panelook / JLX
OLED backing foam | utility | 1 | open-cell PU or EPDM foam pad, 4 mm thick, 10 x 20 mm | - | - | - | sits on the UI board front under the panel (no parts there) and presses the 1.22 mm OLED into its recess behind the 0.8 mm front skin; compresses to about 3.6 mm when the UI board snaps in | any
Through-hole lead trim (hand) | utility | 1 | flush cutters | - | - | - | after soldering, cut every through-hole lead on main to <= 1.5 mm above the back copper (REC3, sockets, PST strips, JP1); the cover wall is 2.0 mm away | assembly step
Main-to-UI FFC cable | electronics | 1 | Wuerth 687708050002 / Molex 15166-0076 / GCT 05-08-D-0050-A / SHOU HAN FFC-0.5-8P-50mm-B | 710-687708050002 (or 538-15166-0076) | 732-3911-ND (or WM10282-ND) | 05-08-D-0050-A (LCSC C42416274) | 8-pin 0.5 mm reverse/opposite-side (Type B / Type 2, 1:1 pin-to-pin between bottom-contact connectors) FFC, 50 mm (0.3 mm insert thickness); main J4 <-> ui J1 | Mouser / Digi-Key / TME / LCSC
DALI supply jumper caps | electronics | 2 | Wuerth 60900213421 / Sullins SPC02SYAN (LCSC C100114) | 710-60900213421 | 732-2703-ND (or S9001-ND) | MJ-0-6 (LCSC C100114) | 2.54 mm closed jumper cap, 3 A; both on main JP1 = internal DALI supply on | Mouser / Digi-Key / TME / LCSC
Case base (snap-fit, no screws) | printed | 1 | enclosure/base.stl | - | - | - | PETG or ASA, 0.2 mm layers, rail channel face down | printed
Case cover (snap-fit, no screws) | printed | 1 | enclosure/cover.stl | - | - | - | PETG or ASA, 0.2 mm layers, front face down (no front text: the left button bump is plain, the right one carries an X) | printed
