vbartusevicius/knx-dali-gateway/hardware/releases/v3/order_lcsc.csv

LCSC Part Number | Quantity | Manufacturer Part Number | Value | Footprint | Designators
C142747 | 1 | 1812L110/33MR | 1.1A | Fuse_1812_4532Metric | main:F1
C149504 | 3 | 0805W8F1003T5E | 100k 1% | R_0805_2012Metric | main:R19,main:R24,main:R5
C14663 | 1 | CC0603KRX7R9BB104 | 100n 50V | C_0603_1608Metric | main:C2
C49678 | 10 | CC0805KRX7R9BB104 | 100n 50V | C_0805_2012Metric | main:C10,main:C14,main:C5,main:C6,ui:C1,ui:C3,ui:C4,ui:C5,ui:C6,ui:C7
C15008 | 1 | CL31A107MQHNNNE | 100u 6.3V | C_1206_3216Metric | main:C23
C17414 | 11 | 0805W8F1002T5E | 10k 1% | R_0805_2012Metric | main:R1,main:R11,main:R15,main:R17,main:R2,main:R25,main:R6,main:R8,ui:R1,ui:R2,ui:R5
C15850 | 3 | CL21A106KAYNNNE | 10u 25V | C_0805_2012Metric | main:C17,main:C19,main:C21
C440198 | 3 | GRM21BR61H106KE43L | 10u 50V | C_0805_2012Metric | main:C11,main:C16,main:C20
C72599 | 1 | MMSZ12T1G | 12V | D_SOD-123 | main:D9
C122519 | 1 | TAXM16M2QLFCDT1T | 16MHz | Crystal_SMD_5032-2Pin_5.0x3.2mm | main:Y1
C25271 | 1 | 0805W8F100KT5E | 1R | R_0805_2012Metric | main:R4
C17513 | 1 | 0805W8F1001T5E | 1k | R_0805_2012Metric | main:R9
C28323 | 7 | CL21B105KBFNNNE | 1u 50V | C_0805_2012Metric | main:C15,main:C18,ui:C10,ui:C11,ui:C2,ui:C8,ui:C9
C4328 | 1 | 0805W8F2002T5E | 20k | R_0805_2012Metric | ui:R3
C64705 | 1 | CL10B224KB8NNNC | 220n 50V | C_0603_1608Metric | main:C3
C91047 | 1 | SWPA6045S221MT | 220uH | L_Sunlord_SWPA6045S | main:L1
C45783 | 3 | CL21A226MAQNNNE | 22u 25V | C_0805_2012Metric | main:C12,main:C13,main:C7
C25478 | 1 | 25121WJ0270T4E | 27R | R_2512_6332Metric | main:R3
C8545 | 1 | 2N7002 | 2N7002 | SOT-23 | main:Q10
C17942 | 1 | 1206W4F200KT5E | 2R | R_1206_3216Metric | main:R18
C17630 | 3 | 0805W8F3300T5E | 330R | R_0805_2012Metric | main:R10,main:R14,ui:R4
C157687 | 2 | 0805CG330J500NT | 33p C0G 50V | C_0805_2012Metric | main:C8,main:C9
C17656 | 1 | 0805W8F3903T5E | 390k | R_0805_2012Metric | ui:R6
C17945 | 1 | 1206W4F330KT5E | 3R3 | R_1206_3216Metric | main:R12
C135248 | 1 | SMNR4012-4R7MT | 4.7uH | L_APV_ANR4012 | main:L2
C48970703 | 1 | RYRVT35V470UF10*10 | 470u 35V | CP_Elec_10x10 | main:C4
C1622 | 1 | CL10B473KB8NNNC | 47n 50V | C_0603_1608Metric | main:C1
C17673 | 5 | 0805W8F4701T5E | 4k7 | R_0805_2012Metric | main:R13,main:R16,main:R21,main:R22,main:R23
C17737 | 1 | 0805W8F5102T5E | 51k 1% | R_0805_2012Metric | main:R7
C236111 | 2 | MMSZ5V6T1G | 5V6 | D_SOD-123 | main:D10,main:D5
C17798 | 1 | 0805W8F6800T5E | 680R | R_0805_2012Metric | main:R20
C7484 | 1 | SN74AHCT1G125DBVR | 74AHCT1G125 | SOT-23-5 | ui:U1
C15127 | 1 | AO3401A | AO3401A | SOT-23 | main:Q9
C8598 | 1 | B5819W SL | B5819W | D_SOD-123 | main:D11
C57668 | 3 | BC847B | BC847 | SOT-23 | main:Q4,main:Q5,main:Q6
C181147 | 1 | BC857C | BC857 | SOT-23 | main:Q2
C66690 | 1 | 2.54-2*2PPin | DALI supply | PinHeader_2x02_P2.54mm_Vertical | main:JP1
C460867 | 1 | DF06S-T | DF06S | Diode_Bridge_Vishay_DFS | main:D6
C67274 | 1 | IRLML0060TRPBF | IRLML0060 | SOT-23 | main:Q3
C2869734 | 1 | LM66100DCKR | LM66100 | SOT-363_SC-70-6 | main:U7
C48580717 | 1 | MJD45H11 | MJD45H11 | TO-252-2 | main:Q1
C513000 | 1 | NCN5130MNTWG | NCN5130MNTWG | QFN-40-1EP_6x6mm_P0.5mm_EP4.6x4.6mm | main:U1
C22371519 | 3 | WS2812B-MINI-V3J | RGB STATUS | LED_WS2812B-MINI-V3J_3.5x3.5mm | ui:D1,ui:D2,ui:D3
C231329 | 2 | B3U-1000P | SCROLL | SW_SPST_B3U-1000P | ui:SW1,ui:SW2
C2693819 | 1 | SCT2400TVBR | SCT2400TVBR | TSOT-23-6 | main:U2
C148222 | 1 | SMAJ24A | SMAJ24A | D_SMA | main:D7
C113966 | 1 | SMAJ33A | SMAJ33A | D_SMA | main:D4
C113970 | 1 | SMAJ40CA | SMAJ40CA | D_SMA | main:D1
C2481 | 3 | SS16 | SS16 | D_SMA | main:D2,main:D3,main:D8
C3002263 | 3 | TLP383(D4BLLTL,E | TLP383 | SO-6L_10x3.84mm_P1.27mm | main:U4,main:U5,main:U6
C52817175 | 1 | TLV803MDBZR-TP | TLV803M supervisor | SOT-23 | main:U10
C48532769 | 2 | KH-FPC0.5-H1.2SMT-8P-QCHF | UI board | FPC_Kinghelm_KH-FPC0.5-H1.2SMT-8P | main:J4,ui:J1
C100114 | 2 | Wuerth 60900213421 / Sullins SPC02SYAN (LCSC C100114) | DALI supply jumper caps |  | hand-fit
C42416274 | 1 | Wuerth 687708050002 / Molex 15166-0076 / GCT 05-08-D-0050-A / SHOU HAN FFC-0.5-8P-50mm-B | Main-to-UI FFC cable |  | hand-fit
C2886701 | 2 | 1x7 2.54 mm female header, 5.0 mm tall (CST 1165SDIG-07, LCSC C2886701; or Samtec SLW-107-01-G-S) | XIAO sockets (hand-soldered) |  | hand-fit
