vbartusevicius/knx-dali-gateway/hardware/releases/v3/main/main.step

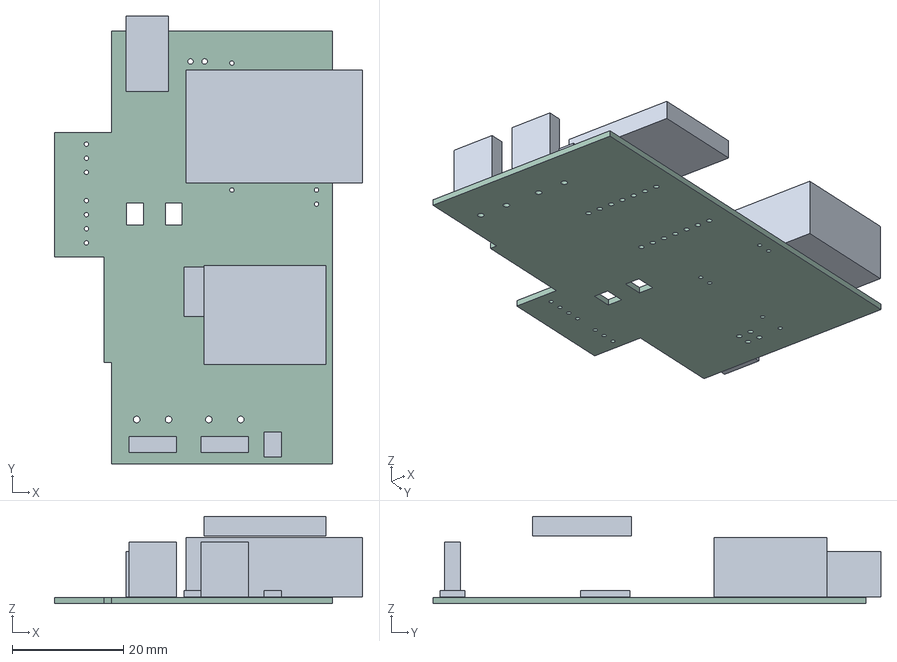
[picture p25: CAD file, 2026-11-11]
hardware/releases/v3/main/main.step
55.5 x 80.7 x 15.7 mm
main_PCB
