vbartusevicius/knx-dali-gateway/hardware/releases/v3/enclosure/assembly.step

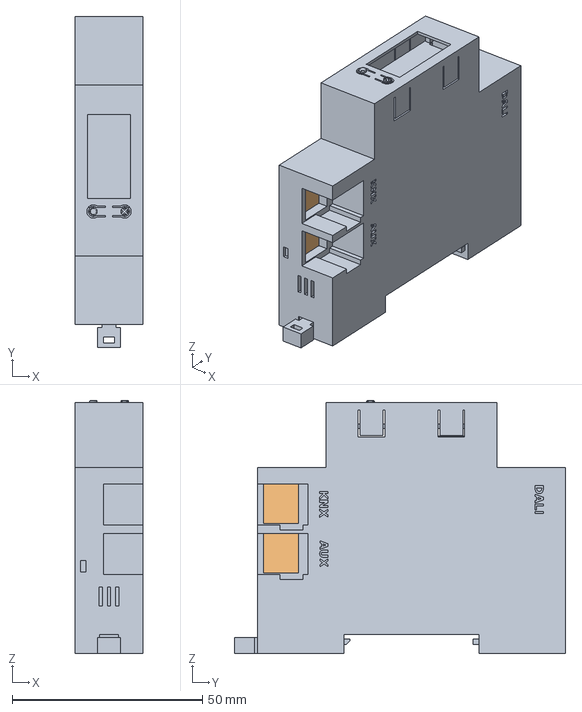
[picture p26: CAD file, 2026-11-11]
hardware/releases/v3/enclosure/assembly.step
18.0 x 87.0 x 66.6 mm
