vbartusevicius/knx-dali-gateway/hardware/releases/v3/enclosure/base.step

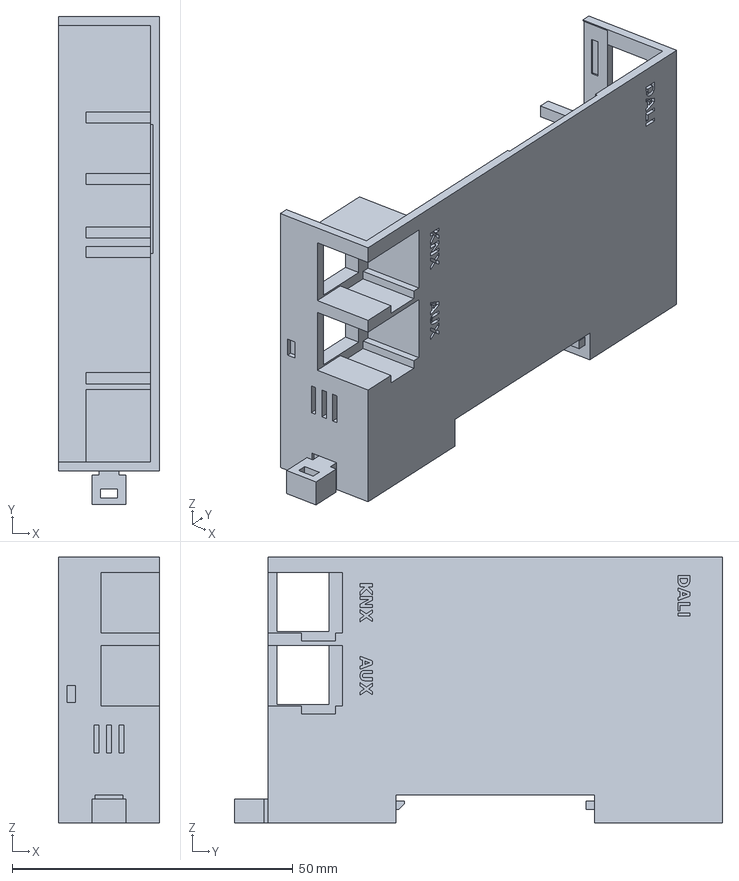
[picture p27: CAD file, 2026-11-11]
hardware/releases/v3/enclosure/base.step
18.0 x 87.0 x 47.4 mm
