vbartusevicius/knx-dali-gateway/hardware/releases/v3/rework/button_pin.step

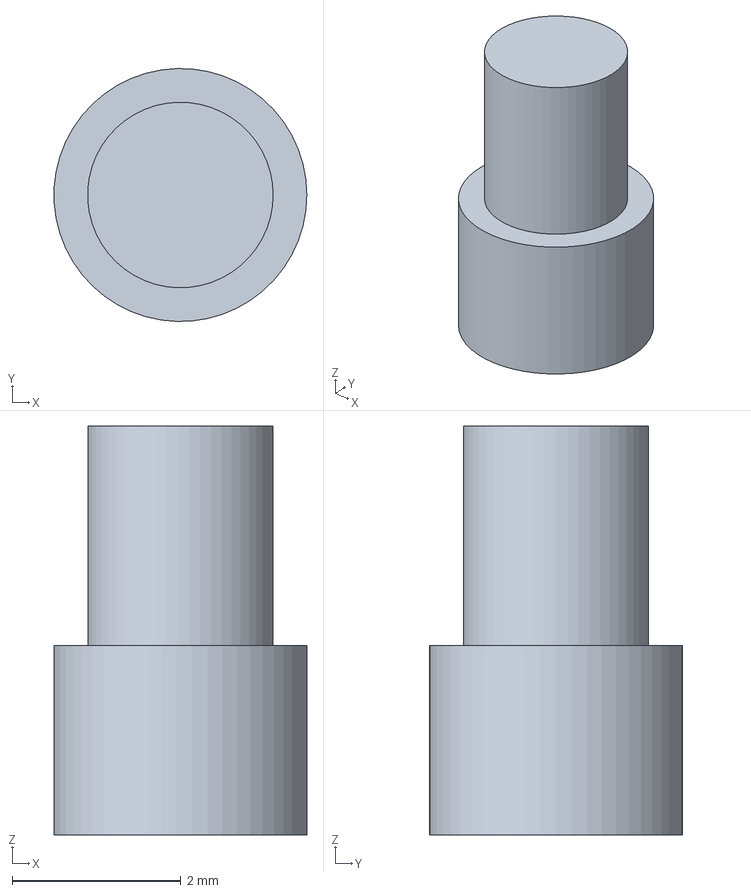
[picture p28: CAD file, 2026-10-22]
hardware/releases/v3/rework/button_pin.step
3.00 x 3.00 x 4.85 mm
