vbartusevicius/knx-dali-gateway/hardware/releases/v3/ui/ui.step

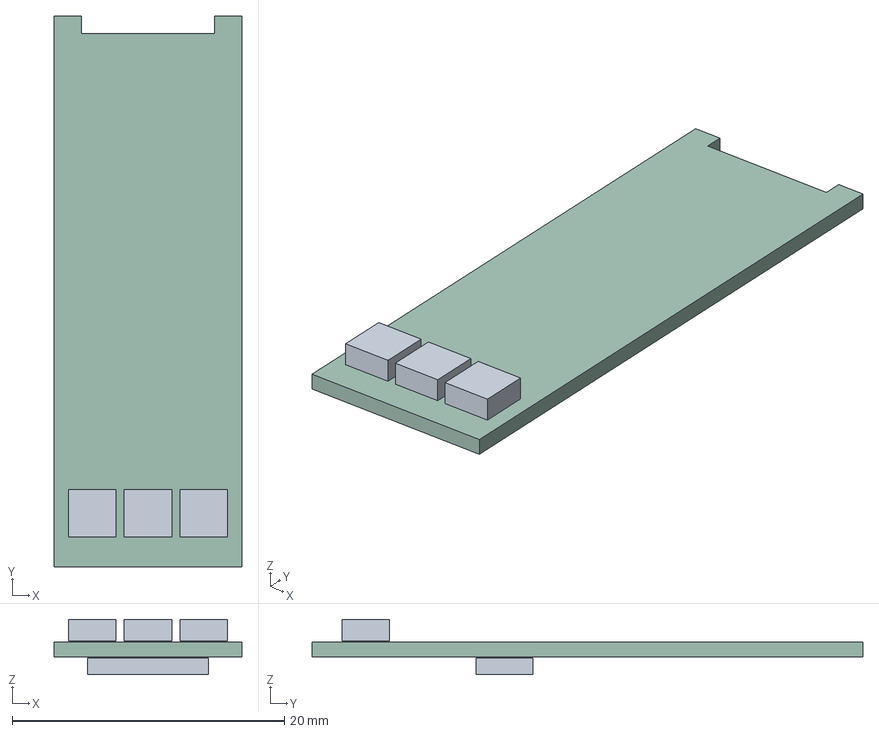
[picture p29: CAD file, 2026-11-11]
hardware/releases/v3/ui/ui.step
13.8 x 40.5 x 4.05 mm
ui_PCB
