vbartusevicius/knx-dali-gateway/hardware/releases/v3/enclosure/cover.step

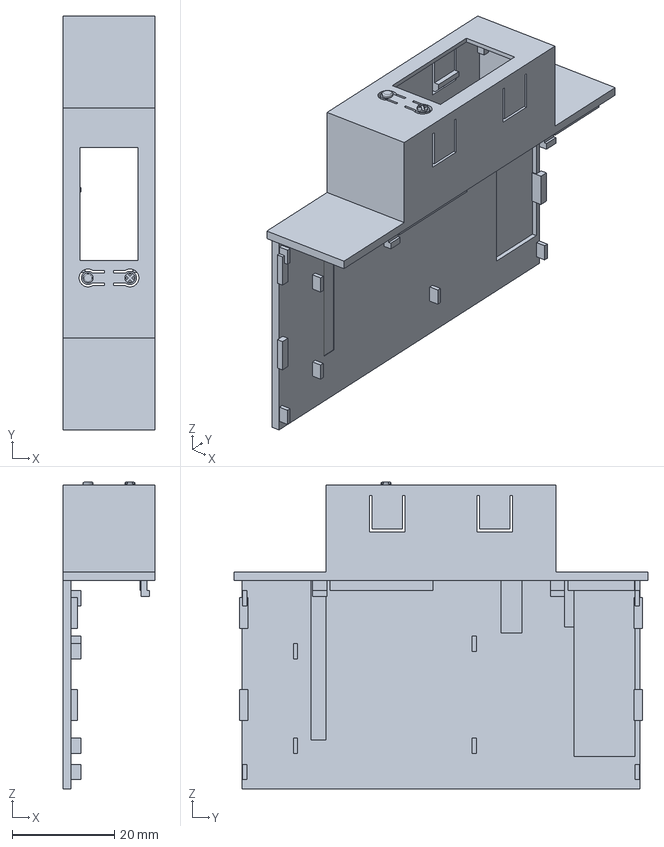
[picture p30: CAD file, 2026-11-11]
hardware/releases/v3/enclosure/cover.step
18.0 x 81.0 x 60.0 mm
