vbartusevicius/knx-dali-gateway/hardware/releases/v3/enclosure/button_area.stl

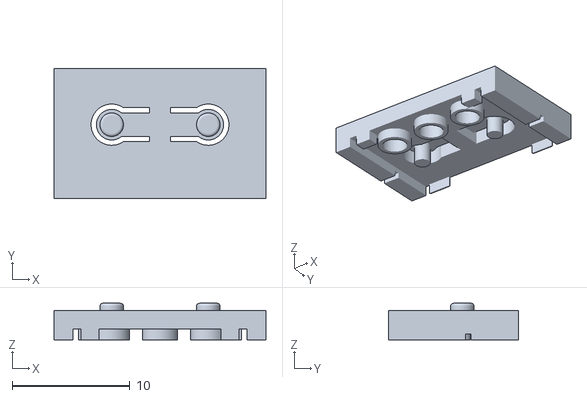
[picture p31: CAD file, 2026-10-22]
hardware/releases/v3/enclosure/button_area.stl
18.0 x 11.0 x 3.10
