vbartusevicius/knx-dali-gateway/hardware/releases/v2/main/main.step

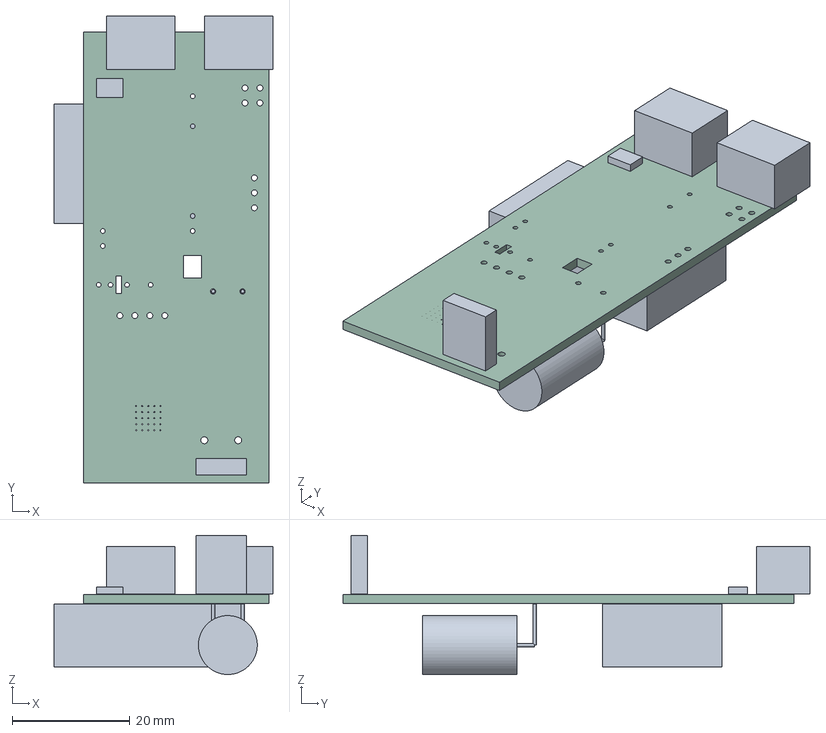
[picture p32: CAD file, 2026-11-11, an earlier design]
hardware/releases/v2/main/main.step
37.1 x 79.2 x 23.6 mm
main_PCB
