vbartusevicius/knx-dali-gateway/hardware/releases/v2/enclosure/assembly.step

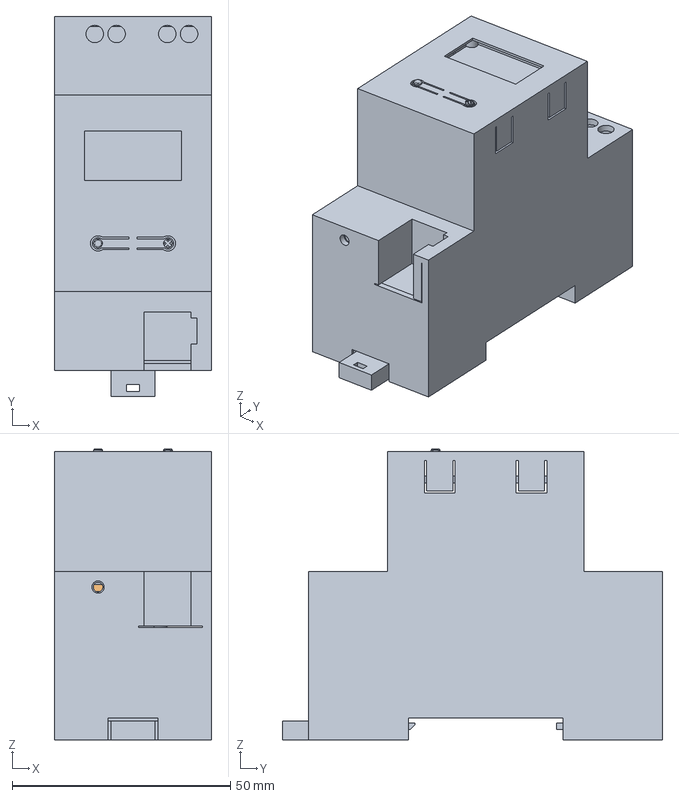
[picture p33: CAD file, 2026-11-11, an earlier design]
hardware/releases/v2/enclosure/assembly.step
36.0 x 87.0 x 66.6 mm
