vbartusevicius/knx-dali-gateway/hardware/releases/v2/enclosure/base.step

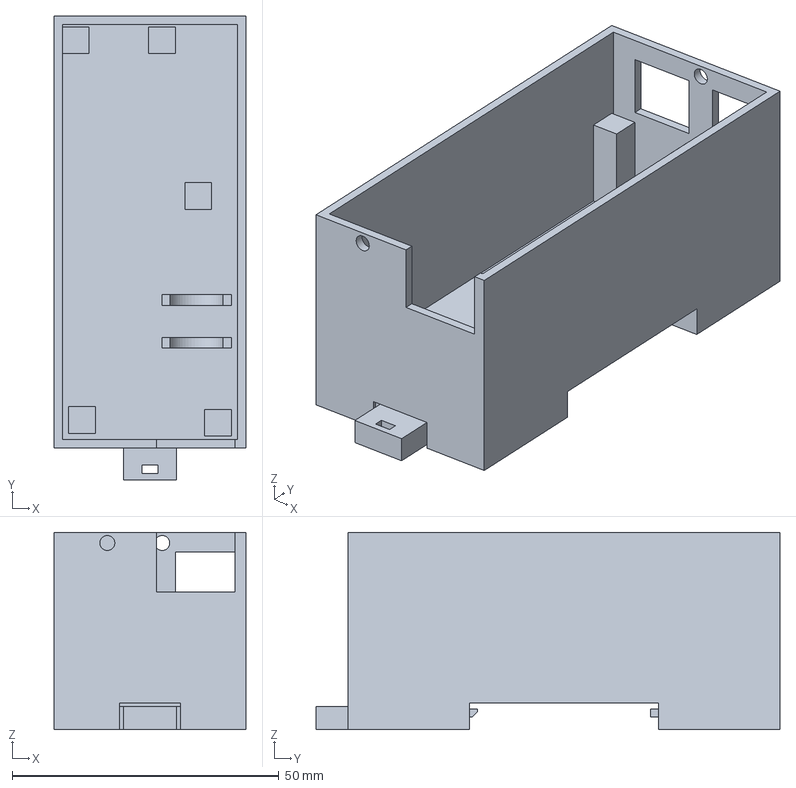
[picture p34: CAD file, 2026-11-11, an earlier design]
hardware/releases/v2/enclosure/base.step
36.0 x 87.0 x 37.0 mm
