vbartusevicius/knx-dali-gateway/hardware/releases/v2/interface/interface.step

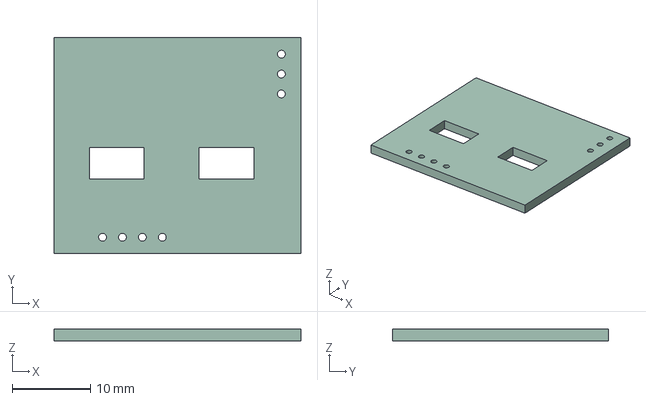
[picture p35: CAD file, 2026-11-11, an earlier design]
hardware/releases/v2/interface/interface.step
31.5 x 27.5 x 1.51 mm
