vbartusevicius/knx-dali-gateway/hardware/releases/v2/ui/ui.step

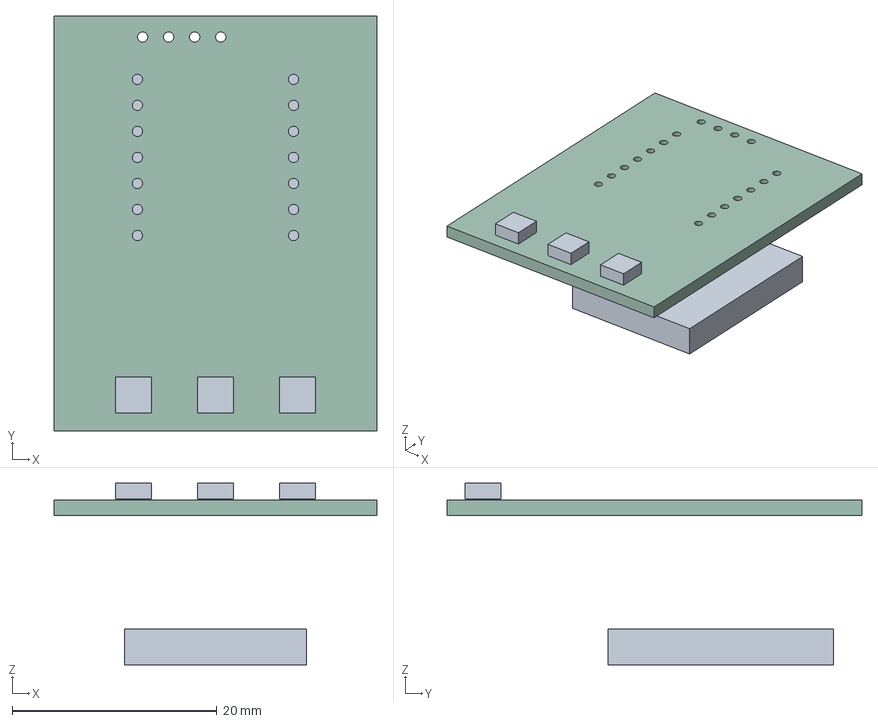
[picture p36: CAD file, 2026-11-11, an earlier design]
hardware/releases/v2/ui/ui.step
31.5 x 40.5 x 17.8 mm
ui_PCB
