vbartusevicius/knx-dali-gateway/hardware/releases/v2/enclosure/cover_embossed.step

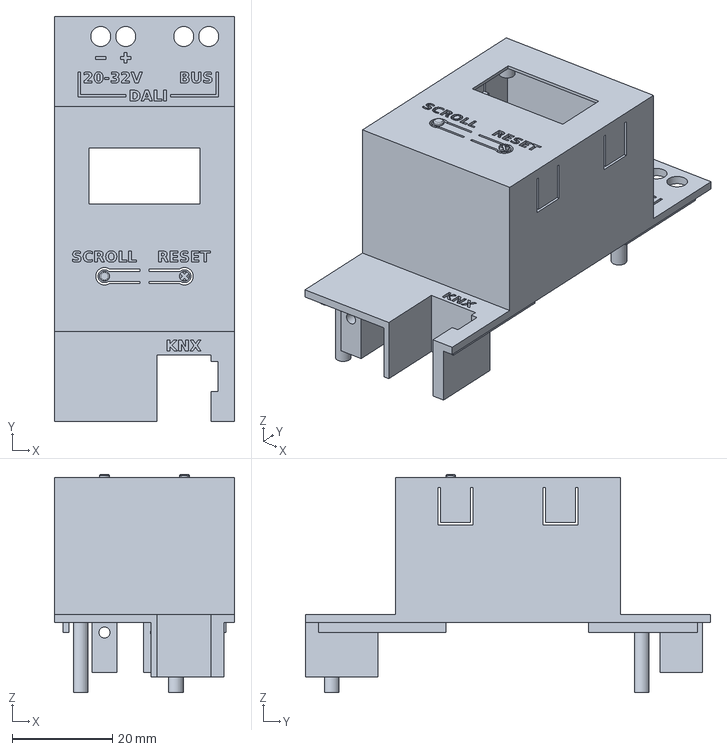
[picture p37: CAD file, 2026-11-11, an earlier design]
hardware/releases/v2/enclosure/cover_embossed.step
36.0 x 81.0 x 43.6 mm
