vbartusevicius/knx-dali-gateway/(list of files, cad)

Other CAD files:
hardware/releases/v2/enclosure/cover.step
hardware/releases/v2/enclosure/base.stl
hardware/releases/v2/enclosure/cover.stl
hardware/releases/v2/enclosure/cover_embossed.stl
hardware/releases/v3/enclosure/base.stl
hardware/releases/v3/enclosure/cover.stl
hardware/releases/v3/rework/button_pin.stl
