vbartusevicius/knx-dali-gateway/hardware/releases/v2/main/main_assembly.pdf

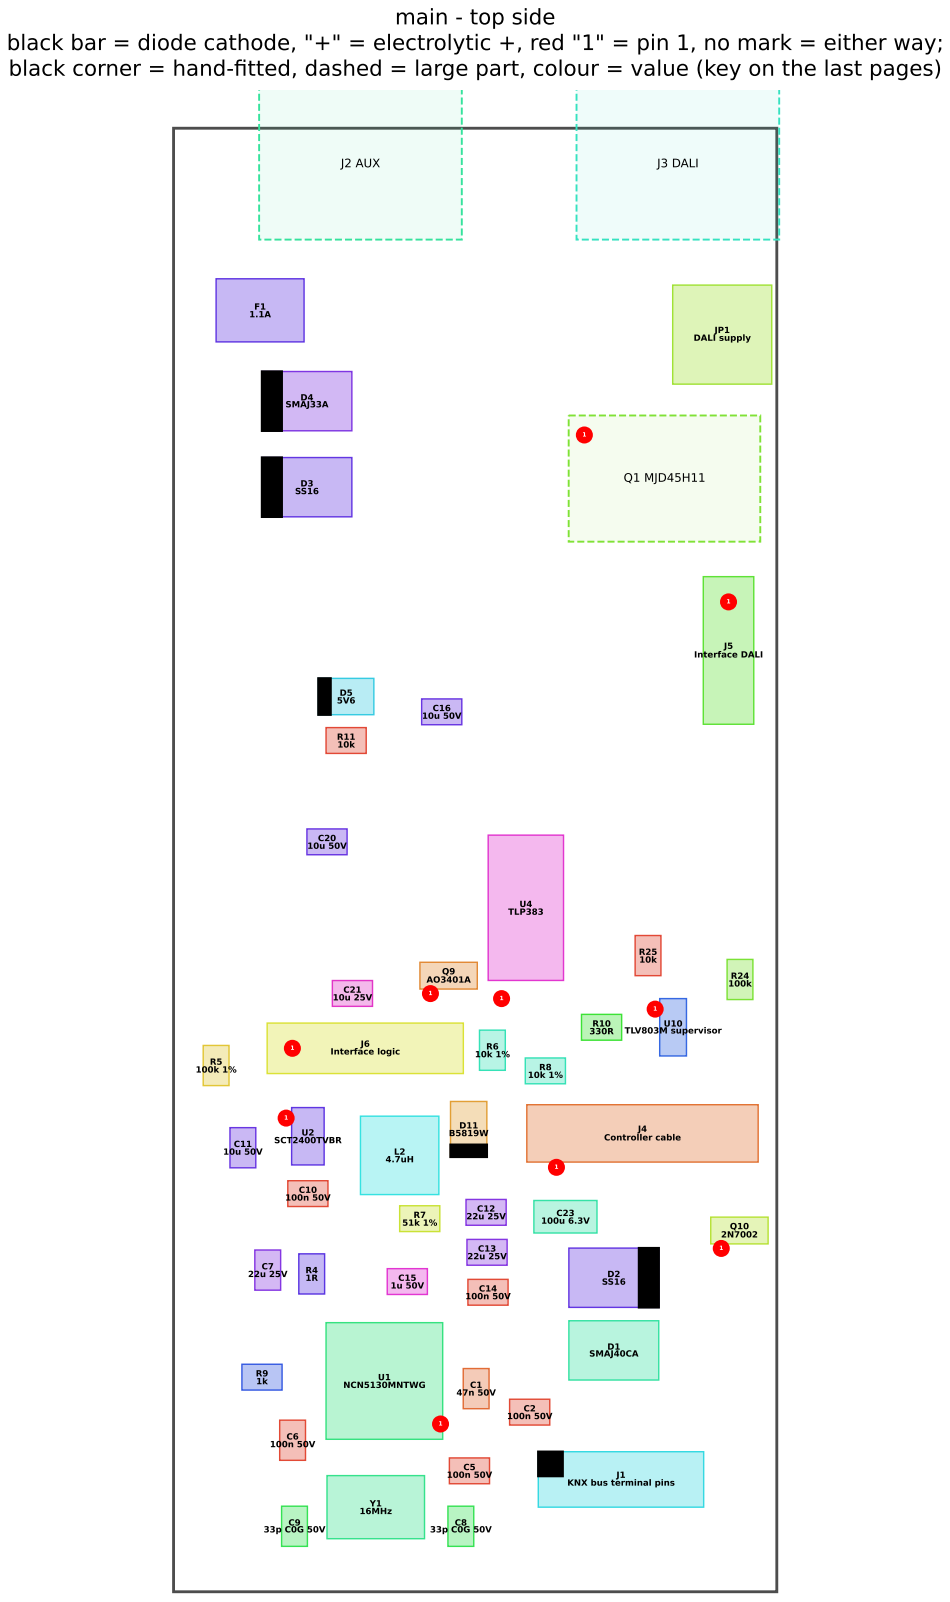
[picture p42: page 1]

black bar = diode cathode, "+" = electrolytic +, red "1" = pin 1, no mark = either way;
black corner = hand-fitted, dashed = large part, colour = value (key on the last pages)

KNX bus terminal pins

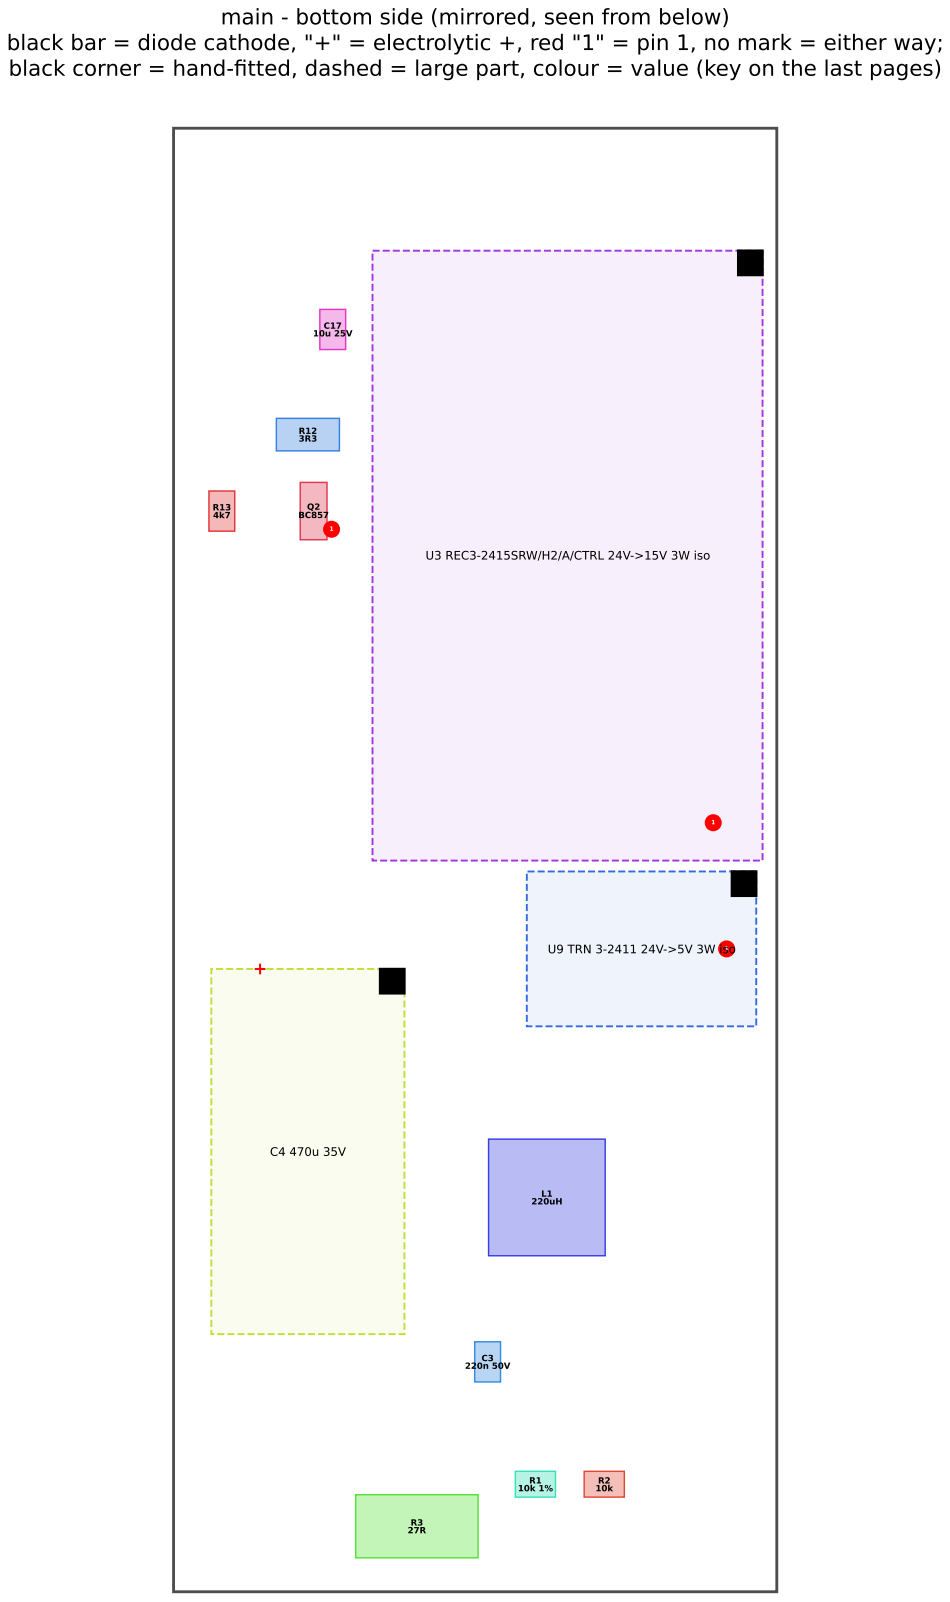
[picture p43: page 2]

main - bottom side (mirrored, seen from below)

black bar = diode cathode, "+" = electrolytic +, red "1" = pin 1, no mark = either way;
black corner = hand-fitted, dashed = large part, colour = value (key on the last pages)

10k | x1 bottom | R2
10k 1% | x1 bottom | R1
10u 25V | x1 bottom | C17
220n 50V | x1 bottom | C3
220uH | x1 bottom | L1
27R | x1 bottom | R3
3R3 | x1 bottom | R12
470u 35V | x1 bottom | C4
4k7 | x1 bottom | R13
BC857 | x1 bottom | Q2
REC3-2415SRW/H2/A/CTRL 24V->15V 3W iso x1 bottom | U3
TRN 3-2411 24V->5V 3W iso | x1 bottom | U9
1.1A | x1 top | F1
100k | x1 top | R24
100k 1% | x1 top | R5
100n 50V | x5 top | C2, C5, C6, C10, C14
100u 6.3V | x1 top | C23
10k | x2 top | R11, R25
10k 1% | x2 top | R6, R8
10u 25V | x1 top | C21
10u 50V | x3 top | C11, C16, C20
16MHz | x1 top | Y1
1R | x1 top | R4
1k | x1 top | R9
1u 50V | x1 top | C15
22u 25V | x3 top | C7, C12, C13
2N7002 | x1 top | Q10
330R | x1 top | R10
33p C0G 50V | x2 top | C8, C9
4.7uH | x1 top | L2
47n 50V | x1 top | C1
51k 1% | x1 top | R7
5V6 | x1 top | D5
AO3401A | x1 top | Q9
AUX | x1 top | J2
B5819W | x1 top | D11
Controller cable | x1 top | J4
DALI | x1 top | J3
DALI supply | x1 top | JP1
Interface DALI | x1 top | J5

### main - values (62 parts)

Interface logic | x1 top | J6
KNX bus terminal pins | x1 top | J1
MJD45H11 | x1 top | Q1
NCN5130MNTWG | x1 top | U1
SCT2400TVBR | x1 top | U2
SMAJ33A | x1 top | D4
SMAJ40CA | x1 top | D1
SS16 | x2 top | D2, D3
TLP383 | x1 top | U4
TLV803M supervisor | x1 top | U10

### main - how to read this drawing and the parts

Black bar = diode cathode (K). The diode body carries a band on that end.

"+" = electrolytic capacitor + pad. The can has a dark stripe (or "-" marks) on the other side.

Red dot "1" = pin 1 of ICs, transistors, LEDs, optocouplers, connectors and modules:

SOT-23 / SOT-23-5 / TSOT-23-6 / SC-70-6: pin 1 is marked by a dot or bevel, or follow the leg pattern

(SOT-23: the single leg is pin 3, opposite pins 1 and 2).

SO-6 optocouplers, the NCN5130 (QFN) and the supervisor: a dot or notch at pin 1 on the package.

WS2812B-MINI-V3J: a notch / marked corner on the body is pin 1 (VDD); the legs differ, so the

footprint only fits one way.

The XIAO, DC-DC converters and the REC3 module: their silkscreen / pin-1 marking and the socket shape.

No mark = fits either way (resistors, ceramic capacitors, inductors, fuse, crystal, pin strips, buttons).

Black corner = fitted by hand (not placed by the assembler); dashed outline = large part.

Same colour = same value (see the values page).

Tools: a 3-5x head magnifier or a 10x loupe and good light are enough to read the bands and

pin-1 dots on SOT-23 and 0805 parts; a USB microscope helps for the NCN5130 QFN and SC-70-6.
