vbartusevicius/knx-dali-gateway/hardware/releases/v2/interface/interface_assembly.pdf

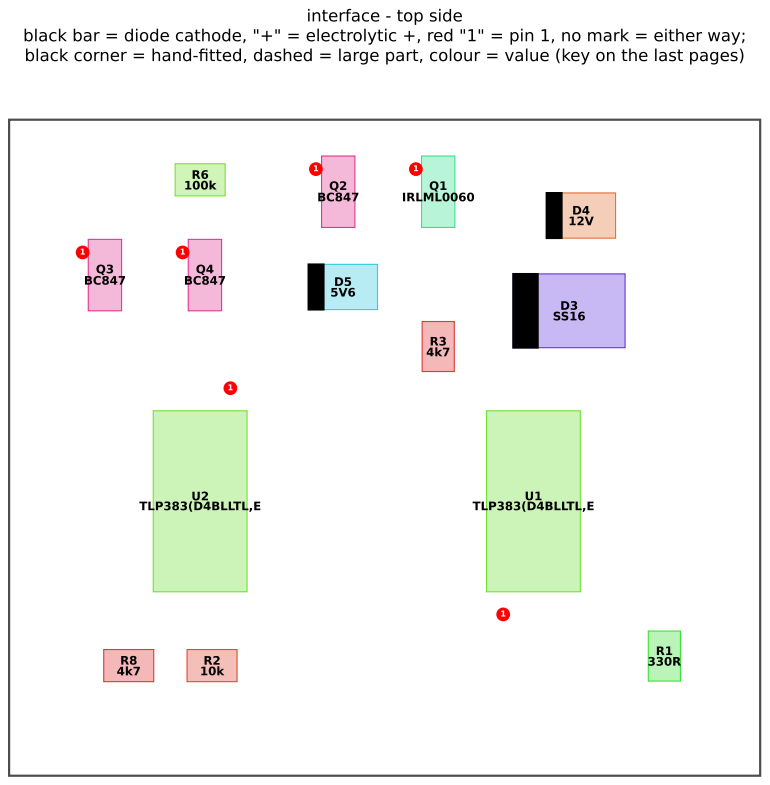
[picture p46: page 1]

black bar = diode cathode, "+" = electrolytic +, red "1" = pin 1, no mark = either way;
black corner = hand-fitted, dashed = large part, colour = value (key on the last pages)

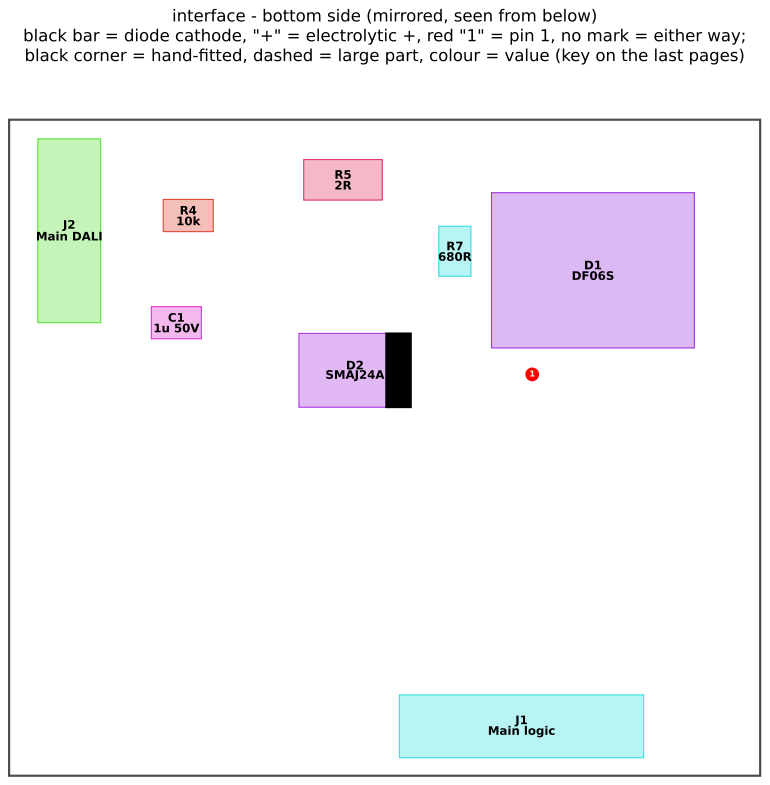
[picture p47: page 2]

interface - bottom side (mirrored, seen from below)

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

10k | x1 bottom | R4
1u 50V | x1 bottom | C1
2R | x1 bottom | R5
680R | x1 bottom | R7
DF06S | x1 bottom | D1
Main DALI | x1 bottom | J2
Main logic | x1 bottom | J1
SMAJ24A | x1 bottom | D2
100k | x1 top | R6
10k | x1 top | R2
12V | x1 top | D4
330R | x1 top | R1
4k7 | x2 top | R3, R8
5V6 | x1 top | D5
BC847 | x3 top | Q2, Q3, Q4
IRLML0060 | x1 top | Q1
SS16 | x1 top | D3
TLP383(D4BLLTL,E | x2 top | U1, U2

### interface - values (22 parts)

### interface - how to read this drawing and the parts

Black bar = diode cathode (K). The diode body carries a band on that end.

"+" = electrolytic capacitor + pad. The can has a dark stripe (or "-" marks) on the other side.

Red dot "1" = pin 1 of ICs, transistors, LEDs, optocouplers, connectors and modules:

SOT-23 / SOT-23-5 / TSOT-23-6 / SC-70-6: pin 1 is marked by a dot or bevel, or follow the leg pattern

(SOT-23: the single leg is pin 3, opposite pins 1 and 2).

SO-6 optocouplers, the NCN5130 (QFN) and the supervisor: a dot or notch at pin 1 on the package.

WS2812B-MINI-V3J: a notch / marked corner on the body is pin 1 (VDD); the legs differ, so the

footprint only fits one way.

The XIAO, DC-DC converters and the REC3 module: their silkscreen / pin-1 marking and the socket shape.

No mark = fits either way (resistors, ceramic capacitors, inductors, fuse, crystal, pin strips, buttons).

Black corner = fitted by hand (not placed by the assembler); dashed outline = large part.

Same colour = same value (see the values page).

Tools: a 3-5x head magnifier or a 10x loupe and good light are enough to read the bands and

pin-1 dots on SOT-23 and 0805 parts; a USB microscope helps for the NCN5130 QFN and SC-70-6.
