vbartusevicius/knx-dali-gateway/hardware/releases/v2/panel/panel.kicad_pcb

## KiCad design hardware/releases/v2/panel/panel.kicad_pcb (2026-11-11, an earlier design)

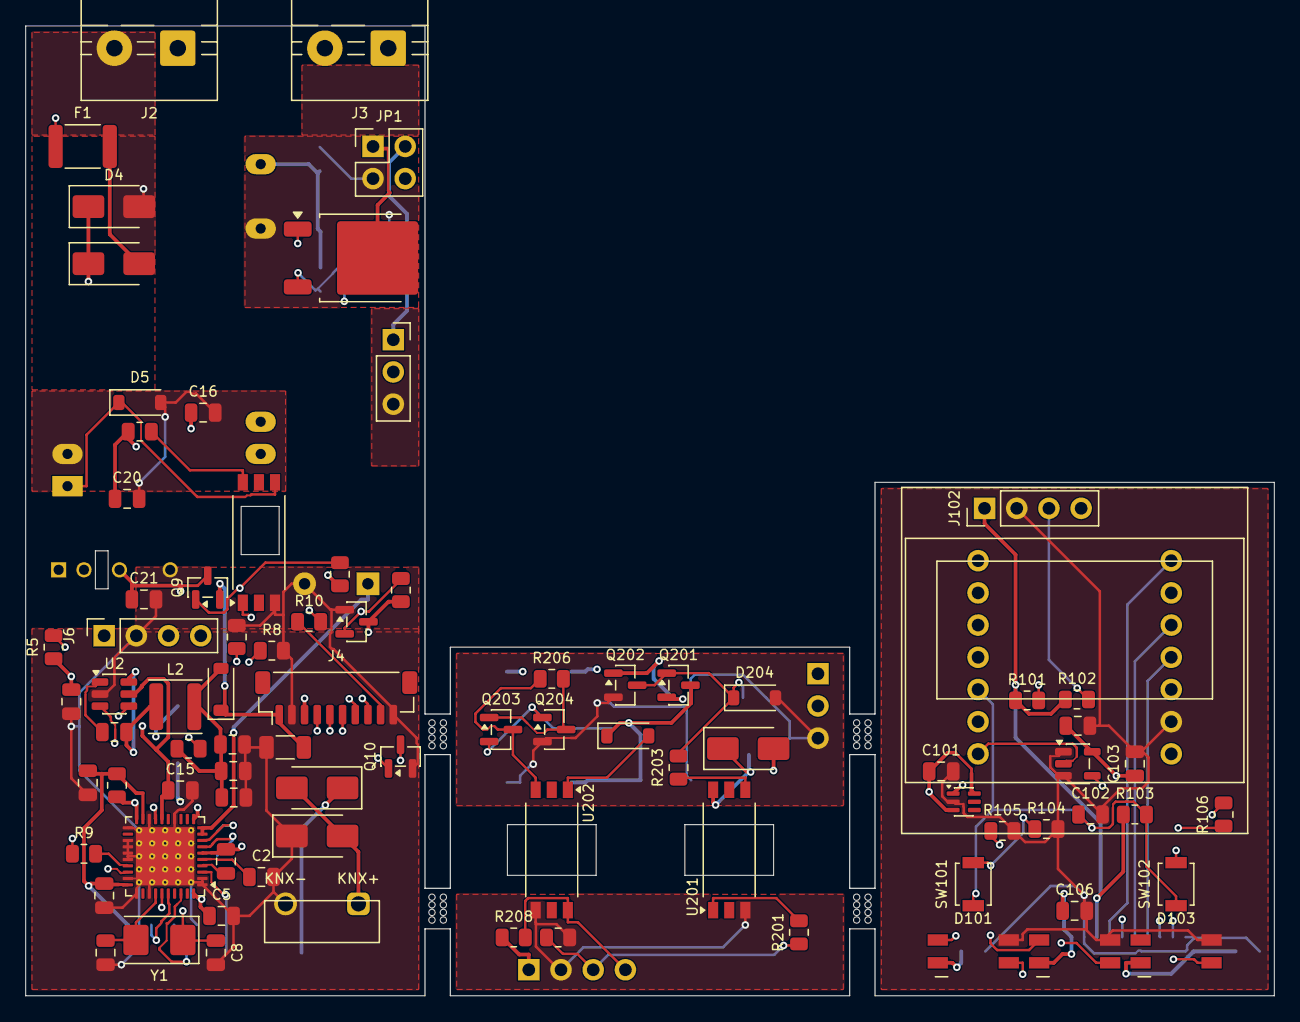
[picture p48: board panel.kicad_pcb from above]

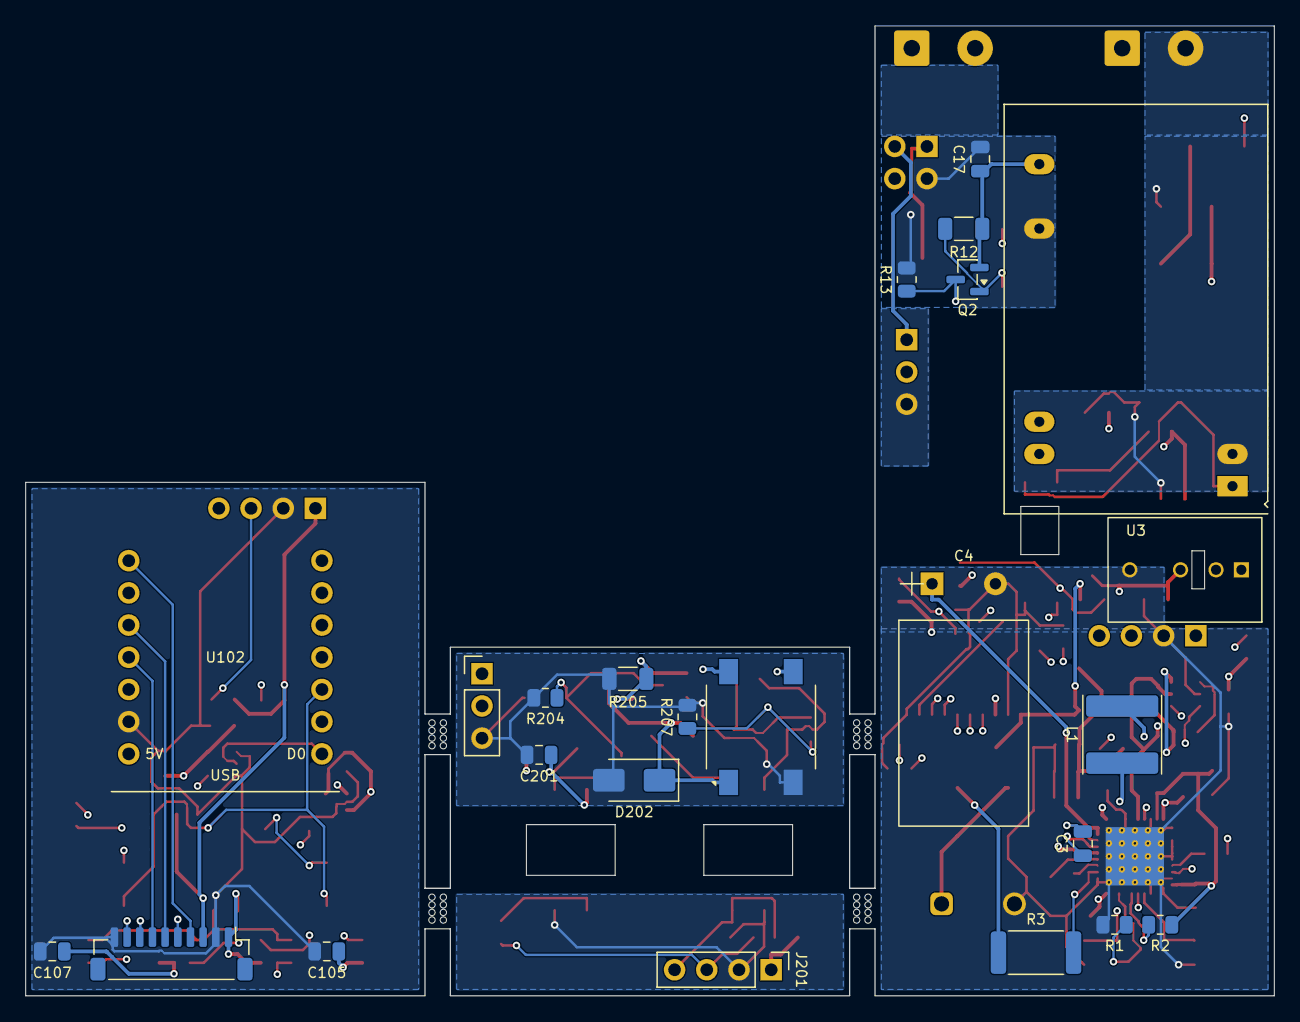
[picture p49: board panel.kicad_pcb from below]

Board: 4 copper layers, 98.5 x 76.5 mm, 139 parts (24 on the bottom side), 83 nets.

Parts:
C1: 47n 50V; C_0805_2012Metric
C2, C5, C6, C10, C14, C102, C104, C105, C106, C107: 100n 50V; C_0805_2012Metric
C3: 220n 50V; C_0805_2012Metric
C4: 470u 35V; CP_Radial_D10.0mm_P5.00mm_Horizontal_Bent
C7, C12, C13: 22u 25V; C_0805_2012Metric
C8, C9: 33p C0G 50V; C_0805_2012Metric
C11, C16, C20: 10u 50V; C_0805_2012Metric
C15, C103, C201: 1u 50V; C_0805_2012Metric
C17, C21, C101: 10u 25V; C_0805_2012Metric
C23: 100u 6.3V; C_1206_3216Metric
D1: SMAJ40CA; D_SMA
D2, D3, D203: SS16; D_SMA
D4: SMAJ33A; D_SMA
D5, D205: 5V6; D_SOD-123
D11: B5819W; D_SOD-123
D101: RGB STATUS; LED_WS2812B-MINI-V3J_3.5x3.5mm
D102: RGB KNX; LED_WS2812B-MINI-V3J_3.5x3.5mm
D103: RGB DALI; LED_WS2812B-MINI-V3J_3.5x3.5mm
D201: DF06S; Diode_Bridge_Vishay_DFS
D202: SMAJ24A; D_SMA
D204: 12V; D_SOD-123
F1: 1.1A; Fuse_1812_4532Metric
J1: KNX bus terminal pins; Phoenix_PST_1,0-2-5,75_R32_1x02_P5.75mm
J2: AUX; TerminalBlock_MaiXu_MX126-5.0-02P_1x02_P5.00mm
J3: DALI; TerminalBlock_MaiXu_MX126-5.0-02P_1x02_P5.00mm
J4, J101: Controller cable; JST_SH_BM10B-SRSS-TB_1x10-1MP_P1.00mm_Vertical
J5: Interface DALI; PinSocket_1x03_P2.54mm_Vertical
J6: Interface logic; PinSocket_1x04_P2.54mm_Vertical
J102: OLED; PinHeader_1x04_P2.54mm_Vertical
J201: Main logic; PinHeader_1x04_P2.54mm_Vertical
J202: Main DALI; PinHeader_1x03_P2.54mm_Vertical
JP1: DALI supply; PinHeader_2x02_P2.54mm_Vertical
L1: 220uH; L_Sunlord_SWPA6045S
L2: 4.7uH; L_APV_ANR4012
MB1, MB2, MB3, MB4, MB5, MB6, MB7, MB8, MB9, MB10, MB11, MB12, MB13, MB14, MB15, MB16, MB17, MB18, MB19, MB20, MB21, MB22, MB23, MB24, MB25, MB26, MB27, MB28, MB29, MB30, MB31, MB32: DNP
Q1: MJD45H11; TO-252-2
Q2: BC857; SOT-23
Q9: AO3401A; SOT-23
Q10: 2N7002; SOT-23
Q201: IRLML0060; SOT-23
Q202, Q203, Q204: BC847; SOT-23
R1, R6, R8: 10k 1%; R_0805_2012Metric
R2, R11, R25, R103, R104, R202, R204: 10k; R_0805_2012Metric
R3: 27R; R_2512_6332Metric
R4: 1R; R_0805_2012Metric
R5: 100k 1%; R_0805_2012Metric
R7: 51k 1%; R_0805_2012Metric
R9: 1k; R_0805_2012Metric
R10, R106, R201: 330R; R_0805_2012Metric
R12: 3R3; R_1206_3216Metric
R13, R101, R102, R203, R208: 4k7; R_0805_2012Metric
R24, R206: 100k; R_0805_2012Metric
R105: 20k; R_0805_2012Metric
R205: 2R; R_1206_3216Metric
R207: 680R; R_0805_2012Metric
SW101: SCROLL; SW_SPST_B3U-1000P
SW102: RESET; SW_SPST_B3U-1000P
U1: NCN5130MNTWG; QFN-40-1EP_6x6mm_P0.5mm_EP4.6x4.6mm_ThermalVias
U2: SCT2400TVBR; TSOT-23-6
U3: REC3-2415SRW/H2/A/CTRL 24V->15V 3W iso; Converter_DCDC_RECOM_REM3_DIP24_CTRL
U4: TLP383; SO-6L_10x3.84mm_P1.27mm
U9: TRN 3-2411 24V->5V 3W iso; Converter_DCDC_TRACO_TRN3_SIP5
U10: TLV803M supervisor; SOT-23
U101: LM66100; SOT-363_SC-70-6
U102: XIAO ESP32C6; XIAO_ESP32C6_Header
U103: 74AHCT1G125; SOT-23-5
U201, U202: TLP383(D4BLLTL,E; SO-6L_10x3.84mm_P1.27mm
Y1: 16MHz; Crystal_SMD_5032-2Pin_5.0x3.2mm

Connections:
+3V3: J4.3, J6.1
+3V3_TRX: C5.1, C6.1, C7.1, R2.1, R4.2, U1.11, U1.19, U1.30, U1.40
+5V: C23.1, D11.1, J4.1, Q9.2, R25.1
+5V_AUX: C21.1, Q9.3, R24.1, U9.3, U10.3
+5V_BUCK: C12.1, C13.1, C14.1, D11.2, L2.2, R7.1
AUX_FUSED: D3.2, F1.2
AUX_P: C16.1, C20.1, D3.1, D4.1, R11.1, U3.22, U3.23, U9.2
CAV: C2.1, U1.5
CCP: C1.2, U1.4
CEQ1: C3.1, U1.7
CEQ2: C3.2, U1.8
CORE_AUX_GOOD: Q10.1, R24.2, U10.2
CORE_PFET_G: Q9.1, Q10.3, R25.2
DA1: J3.1, J5.1, JP1.2
DA2: J3.2, J5.2, JP1.4
DALI_ISO15V: C17.1, Q2.2, R12.1, U3.14
DALI_RX: J4.8, J6.4
DALI_SUPPLY_OFF: J4.9, R10.1
DALI_SUPPLY_SW: JP1.1, Q1.2
DALI_TX: J4.7, J6.3
FANIN: R1.1, U1.38
GND: C2.2, C4.2, C5.2, C6.2, C7.2, C8.2, C9.2, C11.2, C12.2, C13.2, C14.2, C15.2, C21.2, C23.2, D1.1, J1.2, J4.2, J4.10, J6.2, Q10.2, R1.2, R6.2, R8.2, U1.1, U1.2, U1.14, U1.18, U1.21, U1.23, U1.24, U1.25, U1.26, U1.29, U1.31, U1.33, U1.41, U2.2, U4.3, U9.5, U10.1
GNDA: C16.2, C20.2, D4.2, D5.2, J2.2, U3.2, U9.1
GNDD: C17.2, J5.3, JP1.3, R13.2, U3.16
INTERFACE_+3V3: J201.1, R208.1
INTERFACE_DA1: D201.3, J202.1
INTERFACE_DA2: D201.4, J202.2
INTERFACE_DALI_BOOT: C201.1, D203.1, U201.6
INTERFACE_DALI_GATE: D204.1, Q201.1, Q202.3, R203.2, R204.1
INTERFACE_DALI_GATE_SW: R203.1, U201.4
INTERFACE_DALI_RX: J201.4, R208.2, U202.6
INTERFACE_DALI_SENSE: Q201.2, Q202.1, R205.1
INTERFACE_DALI_TX: J201.3, R201.1, R202.1
INTERFACE_DA_P: D201.1, D202.1, D203.2, D205.1, Q201.3
INTERFACE_GND: J201.2, R202.2, U201.3, U202.4
INTERFACE_GNDD: C201.2, D201.2, D202.2, D204.2, J202.3, Q202.2, Q204.2, R204.2, R205.2, R207.2
INTERFACE_N$1: R201.2, U201.1
INTERFACE_N$2: D205.2, U202.1
INTERFACE_N$3: Q203.2, Q204.1, R207.1
INTERFACE_N$4: Q203.1, Q204.3, R206.2
INTERFACE_RX_LIM_IN: Q203.3, R206.1, U202.3
KNX_P: D1.2, D2.2, J1.1
KNX_P_PROT: C1.1, D2.1, R3.1, U1.6
KNX_RXD: J4.5, R9.1
KNX_TXD: J4.4, U1.28
unnamed: R5.2, R6.1, U2.4
unnamed: C10.1, U2.1
unnamed: R7.2, R8.1, U2.3
unnamed: R9.2, U1.27
unnamed: F1.1, J2.1
unnamed: R10.2, U4.1
unnamed: R11.2, U4.6
unnamed: D5.1, U3.1, U4.4
unnamed: Q1.3, Q2.1, R12.2
unnamed: Q1.1, Q2.3, R13.1
NCN_SAVEB: J4.6, R2.2, U1.36
SW: C10.2, L2.1, U2.6
TX0: R3.2, U1.3
UI_+3V3: J101.3, J102.1, R101.1, R102.1, R103.1, U102.12
UI_+5V: C103.1, C104.1, C105.1, C106.1, C107.1, D101.1, D102.1, D103.1, J101.1, U101.1, U103.5
UI_+5V_XIAO: C101.1, U101.3, U101.6, U102.14
UI_BTN_LADDER: C102.1, R103.2, SW101.1, SW102.1, U102.3
UI_DALI_RX: J101.8, U102.9
UI_DALI_SUPPLY_OFF: J101.9, U102.2
UI_DALI_TX: J101.7, U102.11
UI_GND: C101.2, C102.2, C103.2, C104.2, C105.2, C106.2, C107.2, D101.3, D102.3, D103.3, J101.2, J101.10, J102.2, R104.2, R105.2, U101.2, U102.13, U103.1, U103.3
UI_I2C_SCL: J102.3, R102.2, U102.6
UI_I2C_SDA: J102.4, R101.2, U102.5
UI_KNX_RXD: J101.5, U102.7
UI_KNX_TXD: J101.4, U102.8
UI_LED_CHAIN1: D101.2, D102.4
UI_LED_CHAIN2: D102.2, D103.4
UI_LED_DATA: U102.1, U103.2
UI_N$1: R104.1, SW101.2
UI_N$2: R105.1, SW102.2
UI_N$3: R106.1, U103.4
UI_N$4: D101.4, R106.2
UI_NCN_SAVEB: J101.6, U102.10
VDD1M: L1.2, R4.1, U1.20
VFILT: C4.1, C11.1, C15.1, R5.1, U1.9, U1.10, U1.16, U2.5
VSW1: L1.1, U1.17
XTAL1: C8.1, U1.35, Y1.1
XTAL2: C9.1, U1.34, Y1.2
