vbartusevicius/knx-dali-gateway/hardware/layout/v2/ui/ui.kicad_pcb

## KiCad design hardware/layout/v2/ui/ui.kicad_pcb (2026-11-11, an earlier design)

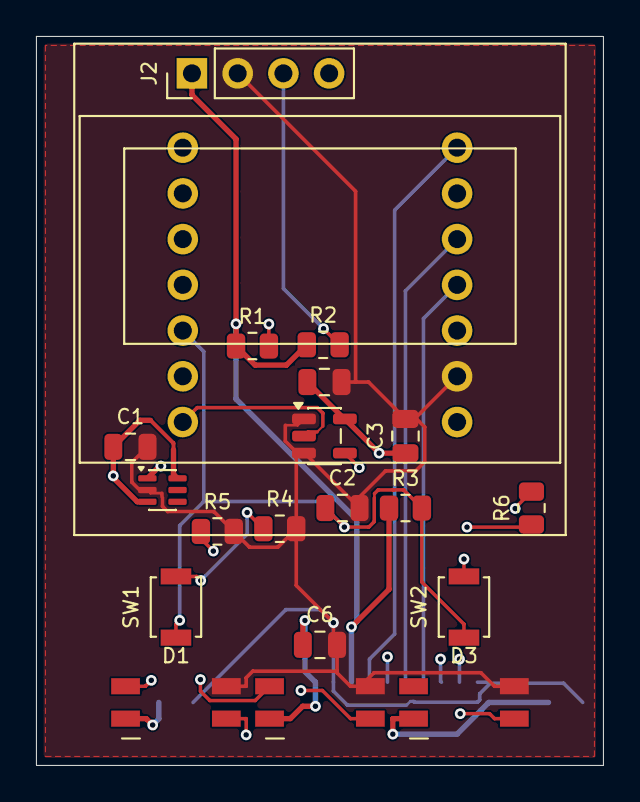
[picture p50: board hardware/layout/v2/ui/ui.kicad_pcb from above]

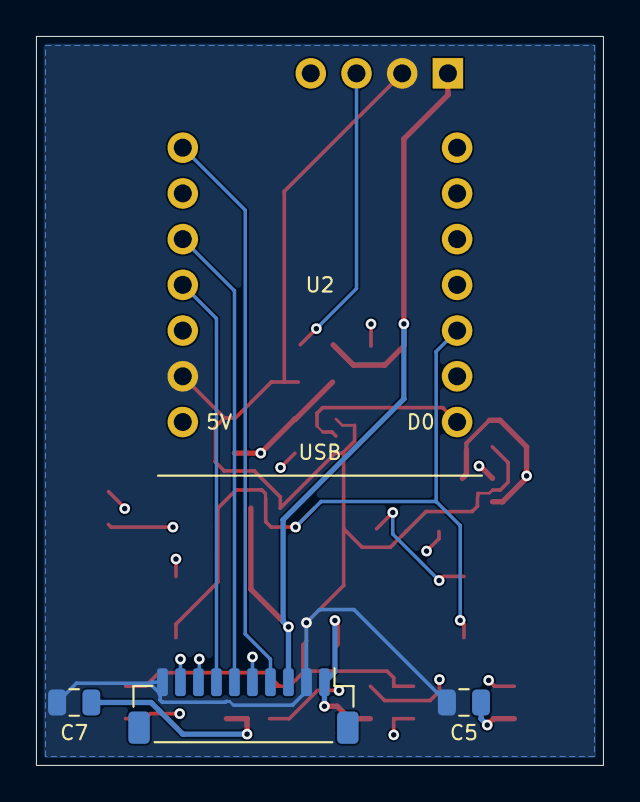
[picture p51: board hardware/layout/v2/ui/ui.kicad_pcb from below]

Board: 4 copper layers, 31.5 x 40.5 mm, 23 parts (4 on the bottom side), 20 nets.

Parts:
C1: 10u 25V; C_0805_2012Metric
C2, C4, C5, C6, C7: 100n 50V; C_0805_2012Metric
C3: 1u 50V; C_0805_2012Metric
D1: RGB STATUS; LED_WS2812B-MINI-V3J_3.5x3.5mm
D2: RGB KNX; LED_WS2812B-MINI-V3J_3.5x3.5mm
D3: RGB DALI; LED_WS2812B-MINI-V3J_3.5x3.5mm
J1: Controller cable; JST_SH_BM10B-SRSS-TB_1x10-1MP_P1.00mm_Vertical
J2: OLED; PinHeader_1x04_P2.54mm_Vertical
R1, R2: 4k7; R_0805_2012Metric
R3, R4: 10k; R_0805_2012Metric
R5: 20k; R_0805_2012Metric
R6: 330R; R_0805_2012Metric
SW1: SCROLL; SW_SPST_B3U-1000P
SW2: RESET; SW_SPST_B3U-1000P
U1: LM66100; SOT-363_SC-70-6
U2: XIAO ESP32C6; XIAO_ESP32C6_Header
U3: 74AHCT1G125; SOT-23-5

Connections:
+3V3: J1.3, J2.1, R1.1, R2.1, R3.1, U2.12
+5V: C3.1, C4.1, C5.1, C6.1, C7.1, D1.1, D2.1, D3.1, J1.1, U1.1, U3.5
+5V_XIAO: C1.1, U1.3, U1.6, U2.14
BTN_LADDER: C2.1, R3.2, SW1.1, SW2.1, U2.3
DALI_RX: J1.8, U2.9
DALI_SUPPLY_OFF: J1.9, U2.2
DALI_TX: J1.7, U2.11
GND: C1.2, C2.2, C3.2, C4.2, C5.2, C6.2, C7.2, D1.3, D2.3, D3.3, J1.2, J1.10, J2.2, R4.2, R5.2, U1.2, U2.13, U3.1, U3.3
I2C_SCL: J2.3, R2.2, U2.6
I2C_SDA: J2.4, R1.2, U2.5
KNX_RXD: J1.5, U2.7
KNX_TXD: J1.4, U2.8
LED_CHAIN1: D1.2, D2.4
LED_CHAIN2: D2.2, D3.4
LED_DATA: U2.1, U3.2
unnamed: R4.1, SW1.2
unnamed: R5.1, SW2.2
unnamed: R6.1, U3.4
unnamed: D1.4, R6.2
NCN_SAVEB: J1.6, U2.10
