vbartusevicius/knx-dali-gateway/hardware/layout/v2/interface/interface.kicad_pcb

## KiCad design hardware/layout/v2/interface/interface.kicad_pcb (2026-11-11, an earlier design)

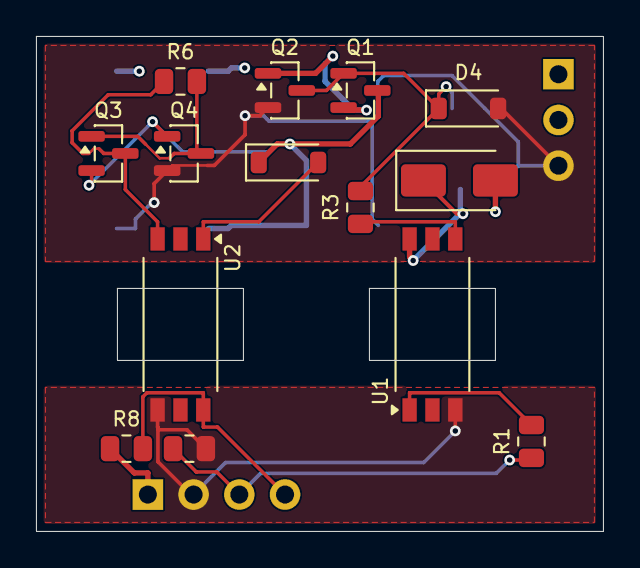
[picture p54: board interface.kicad_pcb from above]

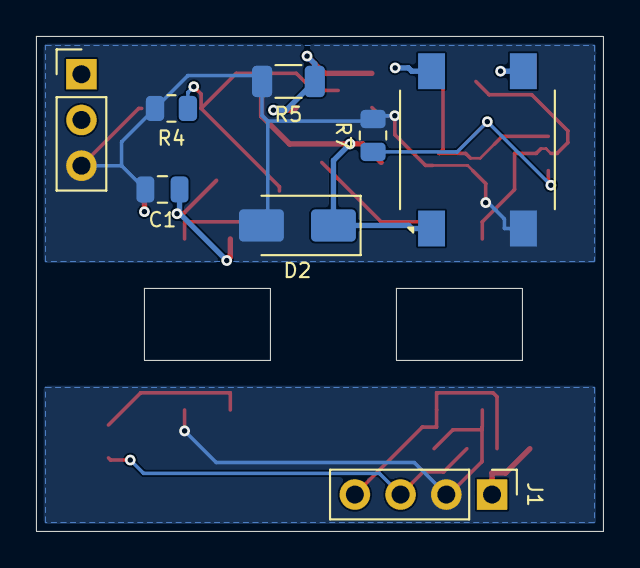
[picture p55: board interface.kicad_pcb from below]

Board: 4 copper layers, 31.5 x 27.5 mm, 22 parts (8 on the bottom side), 17 nets.

Parts:
C1: 1u 50V; C_0805_2012Metric
D1: DF06S; Diode_Bridge_Vishay_DFS
D2: SMAJ24A; D_SMA
D3: SS16; D_SMA
D4: 12V; D_SOD-123
D5: 5V6; D_SOD-123
J1: Main logic; PinHeader_1x04_P2.54mm_Vertical
J2: Main DALI; PinHeader_1x03_P2.54mm_Vertical
Q1: IRLML0060; SOT-23
Q2, Q3, Q4: BC847; SOT-23
R1: 330R; R_0805_2012Metric
R2, R4: 10k; R_0805_2012Metric
R3, R8: 4k7; R_0805_2012Metric
R5: 2R; R_1206_3216Metric
R6: 100k; R_0805_2012Metric
R7: 680R; R_0805_2012Metric
U1, U2: TLP383(D4BLLTL,E; SO-6L_10x3.84mm_P1.27mm

Connections:
+3V3: J1.1, R8.1
DA1: D1.3, J2.1
DA2: D1.4, J2.2
DALI_BOOT: C1.1, D3.1, U1.6
DALI_GATE: D4.1, Q1.1, Q2.3, R3.2, R4.1
DALI_GATE_SW: R3.1, U1.4
DALI_RX: J1.4, R8.2, U2.6
DALI_SENSE: Q1.2, Q2.1, R5.1
DALI_TX: J1.3, R1.1, R2.1
DA_P: D1.1, D2.1, D3.2, D5.1, Q1.3
GND: J1.2, R2.2, U1.3, U2.4
GNDD: C1.2, D1.2, D2.2, D4.2, J2.3, Q2.2, Q4.2, R4.2, R5.2, R7.2
unnamed: R1.2, U1.1
unnamed: D5.2, U2.1
unnamed: Q3.2, Q4.1, R7.1
unnamed: Q3.1, Q4.3, R6.2
RX_LIM_IN: Q3.3, R6.1, U2.3
