vbartusevicius/knx-dali-gateway/hardware/circuits/variants/v3/spec.yaml

active_variant: v3
product:
  revision: D
  release: v3
  status: draft-unvalidated

din_envelope:
  modules: 1
  max_board_width_inside: 13.8
  front_board_max: { width: 13.8, height: 40.5, depth: 15.0 }

variants:
  v3:
    description: "1 DIN, two-sided vertical main board + front UI board"
    modules: 1
    boards: [main, ui]

terminals:
  dali:
    board: main
    shoulder: top
    poles: 2
    pitch: 3.5
    type: push-in spring terminal (WAGO 2086-1202 SMD), wire entry and push-buttons in the top face
    labels: [DA, DA]
  aux_dc:
    board: main
    shoulder: bottom
    poles: 2
    pitch: 5.75
    type: knx-style plug, yellow/white (Phoenix PTS 0,5/2-PH-5,75 GY35YE)
    labels: [AUX+, AUX-]  # 20-32 V; internal DALI supply and the AUX core converter
  knx:
    board: main
    shoulder: bottom
    type: knx-bus-terminal-pins   # red/black plug (Phoenix PTS 0,5/2-PH-5,75 BKRD)
    labels: [KNX+, KNX-]

boards:
  main:
    plane: perpendicular-to-rail   # board x = 41.9 - enc_z, board y = enc_y - 1.5, front faces +enc_x
    thickness: 1.2
    x: -4.2                        # front face (back face at -5.4; 2.0 mm to left wall for THT tails + back SMDs)
    y_offset: 1.5
    z_front: 41.9
    max_outline: { width: 39.8, height: 78.0 }
    isolation:
      - { between: [SELV-KNX, DALI], creepage_min: 5.5, bridged_by: [optocouplers] }
      - { between: [SELV-AUX, DALI], creepage_min: 5.5, bridged_by: [isolated DC-DC] }
      - { between: [SELV-KNX, SELV-AUX], creepage_min: 1.0, bridged_by: [supply-off optocoupler] }
  ui:
    plane: parallel-to-front
    thickness: 1.2
    z: 55.4
    max_outline: { width: 13.8, height: 40.5 }
  interconnects:
    - from: main
      to: ui
      signals: [+3V3, GND, BTN_LADDER, LED_DATA, +5V, I2C_SDA, I2C_SCL, GND]
      refs: { main: J4, ui: J1 }
      domain: SELV-KNX
      type: ffc
      pins: 8

front_ui:
  led_top: 1.57       # WS2812B-MINI-V3J on the front
  board_z: 54.19
  board_top_z: 55.39
  oled:
    header_gap: 4.06      # UI board top to the panel's back plane; glass at 60.9
    module_board: 0.45
    panel: 1.00
    header_plastic_max: 2.5
    pin_tail: 24.99
  display:
    type: oled-0.96in-64x128-ssd1312-i2c-hotbar14
    part: QG-6428TSWCG02 / JLX12864OLED-S096W / NFP1312-15AY (14.0 x 28.0 x 1.22 mm, 14-pin 0.62 mm solder FPC)
    geometry: hardware/circuits/variants/v3/layout_ui.yaml oled_module

enclosure:
  shoulder_z: 44.0
  screw_tabs: []

assembly:
  trim_tht_to: 1.5   # main back side has 2.0 mm to the cover wall: cut every through-hole lead to <= 1.5 mm

mcu:
  board: main
  mounting: "2 x 7 female 2.54 mm headers, 5.0 mm height (+ 2.5 mm pin header plastic + 3.5 mm XIAO = 11.0 mm); 5 V buck and passives underneath"

# --- BEGIN GENERATED (hardware/scripts/gen_circuits.py) ---
derived:
  mcu_pins:
    led_data:
      pin: D0/GPIO0
      net: LED_DATA
      note: RMT, WS2812B-MINI-V3J chain via 5 V buffer on UI
    dali_supply_off:
      pin: D1/GPIO1
      net: DALI_SUPPLY_OFF
      note: high switches the isolated DALI supply off via the CTRL optocoupler
    button_ladder:
      pin: D2/GPIO2
      net: BTN_LADDER
      note: 'ADC ladder: PRG/RST + FUNC on UI board'
    i2c_sda:
      pin: D4/GPIO22
      net: I2C_SDA
      note: OLED on UI board
    i2c_scl:
      pin: D5/GPIO23
      net: I2C_SCL
      note: OLED on UI board
    knx_uart_tx:
      pin: D6/GPIO16
      net: KNX_RXD
      note: MCU TX -> NCN5130 SDI/RXD
    knx_uart_rx:
      pin: D7/GPIO17
      net: KNX_TXD
      note: NCN5130 SDO/TXD -> MCU RX
    dali_rx:
      pin: D8/GPIO19
      net: DALI_RX
      note: RX optocoupler -> RMT RX
    ncn_saveb:
      pin: D9/GPIO20
      net: NCN_SAVEB
      note: NCN5130 SAVEB (open-collector)
    dali_tx:
      pin: D10/GPIO18
      net: DALI_TX
      note: RMT TX -> TX optocoupler
  net_classes:
    main:
      SELV-KNX:
      - GND
      - +3V3
      - +5V_XIAO
      - BTN_LADDER
      - LED_DATA
      - I2C_SDA
      - I2C_SCL
      - KNX_TXD
      - KNX_RXD
      - DALI_TX
      - DALI_RX
      - NCN_SAVEB
      - DALI_SUPPLY_OFF
      - BUCK5_SW
      - +3V3_TRX
      - +20V_SW
      - VDDD
      - VDDA
      - CEQ1
      - CEQ2
      - XTAL1
      - XTAL2
      - XSEL
      - Net-*
      KNX-Power:
      - KNX_P
      - KNX_P_PROT
      - VFILT
      - +5V
      - +5V_BUCK
      - +5V_AUX
      SELV-AUX:
      - GNDA
      - AUX_IN
      - AUX_FUSED
      - AUX_P
      DALI:
      - GNDD
      - DA1
      - DA2
      - DA_P
      - DALI_ISO15V
      - DALI_SUPPLY_SW
      - DALI_BOOT
      - DALI_GATE
      - DALI_GATE_SW
      - DALI_SENSE
      - RX_LIM_IN
    ui:
      SELV-KNX:
      - GND
      - +3V3
      - +5V
      - BTN_LADDER
      - LED_DATA
      - LED_CHAIN1
      - LED_CHAIN2
      - I2C_SDA
      - I2C_SCL
      - Net-*
# --- END GENERATED ---
