vbartusevicius/knx-dali-gateway/gateway/tests/unit/test_lighting/test_bus.cpp

// Copyright (c) 2025 the knx-dali-gateway contributors
#include <vector>

#include <unity.h>

#include "dali/bus/LinkLayer.hpp"
#include "dali/bus/Manchester.hpp"
#include "dali/bus/Timing.hpp"

namespace {

using gateway::dali::bus::Decoded;
using gateway::dali::bus::encode_frame;
using gateway::dali::bus::EncodedFrame;
using gateway::dali::bus::ErrorKind;
using gateway::dali::bus::FrameError;
using gateway::dali::bus::Line;
using gateway::dali::bus::LinkLayer;
using gateway::dali::bus::ManchesterDecoder;
using gateway::dali::bus::Priority;
using gateway::dali::bus::ReceivedFrame;
using gateway::dali::bus::TxOutcome;
using namespace gateway::dali::bus::timing;

const ReceivedFrame* frame_of(const std::optional<Decoded>& result) {
    return result ? std::get_if<ReceivedFrame>(&*result) : nullptr;
}

const FrameError* error_of(const std::optional<Decoded>& result) {
    return result ? std::get_if<FrameError>(&*result) : nullptr;
}

std::optional<Decoded> decode_runs(std::initializer_list<std::pair<Line, std::uint32_t>> runs) {
    ManchesterDecoder decoder;
    std::optional<Decoded> out;
    for (const auto& run : runs) {
        if (const auto result = decoder.feed(run.first, run.second)) {
            out = result;
        }
    }
    if (!out) {
        out = decoder.finish();
    }
    return out;
}

// Re-encodes half-bit pairs for a raw bit cell sequence (1 = active->idle).
std::optional<Decoded> decode_cells(std::initializer_list<bool> cells, std::uint32_t half_us = te_us,
                                    std::uint32_t stop_us_ = stop_us) {
    ManchesterDecoder decoder;
    std::optional<Decoded> out;
    for (const bool cell : cells) {
        const Line first = cell ? Line::Active : Line::Idle;
        const Line second = cell ? Line::Idle : Line::Active;
        for (const Line level : {first, second}) {
            if (const auto result = decoder.feed(level, half_us)) {
                out = result;
            }
        }
    }
    if (const auto result = decoder.feed(Line::Idle, stop_us_)) {
        out = result;
    }
    return out;
}

// -- encoder ---------------------------------------------------------------

void test_encode_starts_with_start_bit() {
    const auto frame = encode_frame(0xFF00, 16);
    TEST_ASSERT_TRUE(frame.count > 0);
    TEST_ASSERT_EQUAL_UINT32(te_us, frame.symbols[0].us);
    TEST_ASSERT_EQUAL(Line::Active, frame.symbols[0].level);
    TEST_ASSERT_EQUAL(Line::Idle, frame.symbols[frame.count - 1].level);
    TEST_ASSERT_TRUE(frame.symbols[frame.count - 1].us >= stop_us);
}

void test_encode_8bit_all_ones_is_alternating() {
    const auto frame = encode_frame(0xFF, 8);
    TEST_ASSERT_EQUAL_UINT8(18, frame.count);
    TEST_ASSERT_EQUAL(Line::Active, frame.symbols[0].level);
    for (std::uint8_t i = 1; i + 1 < frame.count; ++i) {
        TEST_ASSERT_NOT_EQUAL(frame.symbols[i - 1].level, frame.symbols[i].level);
        TEST_ASSERT_EQUAL_UINT32(te_us, frame.symbols[i].us);
    }
    TEST_ASSERT_EQUAL_UINT32(te_us + stop_us, frame.symbols[17].us);
}

void test_encode_8bit_zero_merges_double_idle() {
    const auto frame = encode_frame(0x00, 8);
    TEST_ASSERT_EQUAL_UINT8(18, frame.count);
    TEST_ASSERT_EQUAL_UINT32(te_us, frame.symbols[0].us);
    TEST_ASSERT_EQUAL(Line::Idle, frame.symbols[1].level);
    TEST_ASSERT_EQUAL_UINT32(2 * te_us, frame.symbols[1].us);
    TEST_ASSERT_EQUAL_UINT32(stop_us, frame.symbols[17].us);
    TEST_ASSERT_EQUAL(Line::Idle, frame.symbols[17].level);
}

void test_encode_rejects_bad_lengths() {
    TEST_ASSERT_EQUAL_UINT8(0, encode_frame(0, 0).count);
    TEST_ASSERT_EQUAL_UINT8(0, encode_frame(0, 7).count);
    TEST_ASSERT_EQUAL_UINT8(0, encode_frame(0, 32).count);
}

// -- decoder: round trips ---------------------------------------------------

std::optional<Decoded> round_trip(std::uint32_t value, std::uint8_t bits) {
    const auto frame = encode_frame(value, bits);
    ManchesterDecoder decoder;
    std::optional<Decoded> out;
    for (std::uint8_t i = 0; i < frame.count; ++i) {
        if (const auto result = decoder.feed(frame.symbols[i].level, frame.symbols[i].us)) {
            out = result;
        }
    }
    if (!out) {
        out = decoder.finish();
    }
    return out;
}

void test_round_trip_frames() {
    const std::pair<std::uint32_t, std::uint8_t> vectors[] = {
        {0x00, 8},    {0xFF, 8},      {0xA5, 8},      {0x0000, 16},   {0xFF00, 16},   {0xA3FF, 16},
        {0xFFFF, 16}, {0x000000, 24}, {0xFFFE1D, 24}, {0xABCDEF, 24}, {0x123456, 24},
    };
    for (const auto& vector : vectors) {
        const auto decoded = round_trip(vector.first, vector.second);
        const auto* decoded_frame = frame_of(decoded);
        TEST_ASSERT_NOT_NULL(decoded_frame);
        TEST_ASSERT_EQUAL_UINT32(vector.first, decoded_frame->value);
        TEST_ASSERT_EQUAL_UINT8(vector.second, decoded_frame->bits);
    }
}

// -- decoder: tolerance and errors ------------------------------------------

void test_decoder_accepts_tolerance_edges() {
    // Start + 8 payload ones at the half-bit extremes.
    for (const std::uint32_t half : {rx_half_min_us, rx_half_max_us}) {
        const auto result = decode_cells({true, true, true, true, true, true, true, true, true}, half);
        const auto* frame = frame_of(result);
        TEST_ASSERT_NOT_NULL(frame);
        TEST_ASSERT_EQUAL_UINT8(8, frame->bits);
        TEST_ASSERT_EQUAL_UINT32(0xFF, frame->value);
    }
    // A '1'->'0' boundary merges two Idle half-bits into one full-bit run;
    // check both ends of the full-bit window. Frame: start bit + 0x00.
    for (const std::uint32_t span : {rx_full_min_us, rx_full_max_us}) {
        const auto merged = decode_runs({
            {Line::Active, te_us},
            {Line::Idle, span},
            {Line::Active, te_us},
            {Line::Idle, te_us},
            {Line::Active, te_us},
            {Line::Idle, te_us},
            {Line::Active, te_us},
            {Line::Idle, te_us},
            {Line::Active, te_us},
            {Line::Idle, te_us},
            {Line::Active, te_us},
            {Line::Idle, te_us},
            {Line::Active, te_us},
            {Line::Idle, te_us},
            {Line::Active, te_us},
            {Line::Idle, te_us},
            {Line::Active, te_us},
            {Line::Idle, stop_us},
        });
        const auto* frame = frame_of(merged);
        TEST_ASSERT_NOT_NULL(frame);
        TEST_ASSERT_EQUAL_UINT8(8, frame->bits);
        TEST_ASSERT_EQUAL_UINT32(0x00, frame->value);
    }
    // '0'->'1' and '1'->'0' boundaries also merge Active and Idle runs.
    const auto active_merge = decode_runs({
        {Line::Active, te_us},
        {Line::Idle, rx_full_min_us},
        {Line::Active, rx_full_max_us},
        {Line::Idle, rx_full_min_us},
        {Line::Active, te_us},
        {Line::Idle, te_us},
        {Line::Active, te_us},
        {Line::Idle, te_us},
        {Line::Active, te_us},
        {Line::Idle, te_us},
        {Line::Active, te_us},
        {Line::Idle, te_us},
        {Line::Active, te_us},
        {Line::Idle, te_us},
        {Line::Active, te_us},
        {Line::Idle, stop_us},
    });
    const auto* merged_frame = frame_of(active_merge);
    TEST_ASSERT_NOT_NULL(merged_frame);
    TEST_ASSERT_EQUAL_UINT8(8, merged_frame->bits);
    TEST_ASSERT_EQUAL_UINT32(0x40, merged_frame->value);
}
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
