vbartusevicius/knx-dali-gateway/(commit log)

2026-10-10 KNX-DALI communication and PCB layouts
    [lower.kicad_pcb, lower.placed.kicad_pcb, upper.kicad_pcb, upper.placed.kicad_pcb]
2026-10-12 updated structure
    [lower.kicad_pcb, lower.placed.kicad_pcb, upper.kicad_pcb, upper.placed.kicad_pcb]
2026-10-13 CI matrix for hardware variants (poc/v2); updated AGENTS.md with V2 details and verification workflow
    [assembly.step, assembly_parts.csv, base.step, base.stl, cover.step, cover.stl, interface.kicad_pcb, interface.step]
2026-10-13 Renamed poc variant to v1 for consistent hardware versioning
    [main.kicad_pcb, ui.kicad_pcb]
2026-10-13 Updated V2 UI board placement for centered front legend alignment; added legend color model generation to CI workflow
    [base.step, cover.step, cover.stl, cover_color.3mf, ui.kicad_pcb, ui.step, ui_assembly_check.csv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]
2026-10-14 V3 hardware complete: four boards routed and released with 1-DIN enclosure; CI matrix updated; REM3/CTRL supply-off circuit added
    [assembly.step, assembly_parts.csv, base.step, base.stl, cover.step, cover.stl, cover_color.3mf, dali.kicad_pcb]
2026-10-14 V3 consolidated to two boards (main + ui); updated firmware pin map, button ADC, and OLED connector; removed separate knx/dali boards from CI matrix
    [assembly.step, assembly_parts.csv, base.step, base.stl, cover.step, cover.stl, cover_color.3mf, cover_embossed.step]
2026-10-14 README, hardware docs, and clangd config updates: expanded V3 details with REM3 supply control, isolation specs, and 1-DIN assembly; added system include resolution to compiledb script; updated varia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
    [assembly.step, assembly_parts.csv, base.step, base.stl, cover.step, cover.stl, cover_color.3mf, cover_embossed.step]
2026-10-14 Simplified build.py invocation in README; auto-generated assembly_parts.yaml from parts.json for V2/V3 with consistent formatting and descriptions; corrected V2/V3 cover variant descriptions (plain/e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
    [assembly.step, assembly_parts.csv, base.step, cover.step, cover_color.3mf, cover_embossed.step, cover_embossed.stl, interface.kicad_pcb]
2026-10-15 Expanded AGENTS.md summary with complete firmware/hardware/mechanical implementation across V1/V2/V3 variants; added unified XIAO ESP32-C6 pinout, REM3-2415S/A/CTRL DALI supply control, automated ass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
    [partitions.csv]
2026-10-15 V3 OLED updated to 0.96" 64×128 portrait
    [assembly.step, assembly_parts.csv, base.step, cover.step, cover.stl, cover_color.3mf, cover_embossed.step, cover_embossed.stl]
2026-10-15 V1/V2 OLED layout updated: split glass substrate into panel (26.7×19.26) and active display area (21.74×10.86); adjusted V1 Y-offset from 31.87→38.47 and V2 from 51.53→49.73; regenerated enclosure as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
    [assembly.step, base.step, cover.step, cover.stl, cover_color.3mf, cover_embossed.step, cover_embossed.stl, interface.step]
2026-10-15 Updated web UI with comprehensive DALI power monitoring, DT8 colour controls, and IEC 62386 parameter tuning
2026-10-15 Updated web UI power monitoring with D4i IEC 62386-252 MB202 native power/energy reporting, per-ballast manual override, and separate 100% lamp + ballast idle power configuration; added D4i badge to 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
2026-10-15 Web UI redesigned: consolidated hardware status into slim single-line strip with pill-style stats; split lamp inspector into Control/Settings tabs with percentage-based dimming limits and curve selec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
    [RuntimeState.cpp]
2026-10-15 Web UI logs redesigned
    [DaliDebugTrace.hpp, RuntimeState.hpp]
2026-10-16 Added breakaway panel generation for V2/V3 releases with consolidated BOM/CPL and updated README with single-panel ordering instructions
    [assembly.step, interface.step, main.step, panel.kicad_pcb, panel_assembly_check.csv, panel_bom_jlc.csv, panel_hand_fit.csv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]
2026-10-16 Updated V3 UI board thickness from 1.6mm to 1.2mm and adjusted front panel Z-position accordingly
    [assembly.step, base.step, cover.step, cover.stl, cover_color.3mf, cover_embossed.step, cover_embossed.stl, main.kicad_pcb]
2026-10-16 Regenerated V1 hardware release files with updated timestamps and mouse bite footprint reference consolidation
    [interface.step, main.step, panel.kicad_pcb, panel_assembly_check.csv, panel_bom_jlc.csv, panel_hand_fit.csv, ui.step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]
2026-10-16 Updated V3 FFC cable specification from Type A same-side to Type B reverse/opposite-side (LCSC C42416274) in README and assembly documentation
    [assembly_parts.csv, main.kicad_pcb, main.step, panel.kicad_pcb, ui.kicad_pcb, ui.step]
2026-10-17 Added custom naming support for channels and groups with persistent storage, D4i power polling during commissioning, and updated web UI to display and edit names in lamp/group tiles and inspector pan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
    [assembly.step, base.step, base.stl, cover.step, cover.stl, cover_color.3mf, cover_embossed.step, cover_embossed.stl]
2026-10-17 Replaced V3 OLED connector from 14-pin 0.5mm ZIF FPC to 14-pin 0.62mm pitch direct-solder FPC footprint, relocated UI board passives to accommodate new layout with top-edge notch adjusted to 9.8mm wi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
    [assembly_parts.csv, main.step, panel.kicad_pcb, panel_assembly_check.csv, panel_bom_jlc.csv, panel_hand_fit.csv, ui.kicad_pcb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]
2026-10-17 Corrected OLED active area vertical position from 14.5mm to 13.1mm (1.6mm from bottom edge) in V3 UI board layout configuration and regenerated PCB with updated footprint UUIDs
    [main.step, panel.kicad_pcb, ui.kicad_pcb, ui.step]
2026-10-17 Updated DALI DC-DC converter from RECOM REM3-2415S/A to REC3-2415SRW/H2/A series across all variants, changed V3 OLED from 14-pin 0.5mm ZIF to 14-pin 0.62mm solder-tail FPC connector, and expanded as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
    [assembly.step, assembly_parts.csv, base.step, cover.step, cover.stl, cover_color.3mf, cover_embossed.step, cover_embossed.stl]
2026-10-22 Removed V1 hardware variant including main and UI board layouts, schematics, and all associated configuration files
    [assembly.step, assembly_parts.csv, base.step, base.stl, cover.step, cover.stl, cover_color.3mf, cover_embossed.step]
2026-10-22 Removed V1 hardware variant from CI workflows, updated AGENTS.md documentation to reflect V2/V3-only support
    [assembly.step, assembly_parts.csv, base.step, base.stl, button_area.stl, button_pin.step, button_pin.stl, cover.step]
2026-10-23 Updated AUX-to-core converter from 1W TMR 1-2411 to 2W TMR 2411 (v3) and 3W TRN 3-2411 (v2) to handle WiFi TX peaks without KNX handover, relocated v3 converter to front protrusion tongue with AUX fe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
    [assembly.step, assembly_parts.csv, base.step, base.stl, cover.step, cover.stl, cover_color.3mf, cover_embossed.step]
2026-10-23 Unified V2/V3 UI buttons to Omron B3U-1000P with cover spring tabs
    [assembly.step, base.step, cover.step, cover.stl, cover_color.3mf, cover_embossed.step, cover_embossed.stl, interface.step]
2026-10-23 Updated AGENTS.md and README with documentation on README image composition workflow, restructured README with hero image and collapsible galleries, expanded hardware variant comparison table, added 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
2026-10-23 Removed LittleFS web UI partition in favor of compiled-in assets, updated CI to publish firmware.bin and firmware-full-usb.bin artifacts, removed web flasher deployment, reduced flash size to 4MB, me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
    [partitions.csv]
2026-10-23 Added .DS_Store to .gitignore, documented ETS parameter UI design (device slot-based input module with 8 slots of 4 instances each, selection grids, online commissioning buttons, group membership che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
2026-10-27 Removed color cover 3MF and OBJ files from v2/v3 enclosure releases
    [assembly_parts.csv, cover_color.3mf, interface.step, interface_bom.csv, main.step, main_bom.csv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]
2026-10-28 Added v3 rev C to rev D migration guide with part transfer maps, BOM, and assembly instructions
    [transfer.csv]
2026-10-29 added order CSV generation for self-assembly
    [assembly_parts.csv, order_elsewhere.csv, order_lcsc.csv, order_mouser.csv]
2026-10-29 Updated AGENTS.md to document assembly_parts.yaml as auto-generated by gen_circuits.py, not hand-editable
2026-10-29 Added zero-length track segments to fix hairline joints where track ends grazed pads instead of fully entering them
    [main.kicad_pcb, main.step, panel.kicad_pcb, ui.kicad_pcb, ui.step]
2026-10-30 Replaced order_mouser.csv with order_elsewhere.csv containing all electronics LCSC does not sell
    [assembly_parts.csv, order_elsewhere.csv, order_mouser.csv]
2026-11-09 Replaced the V3 DALI terminal with a hand-soldered WAGO 2086 SMD push-in connector, updated board layout, models, BOM, and rework documentation, and added enclosure supports and print-rule tests; ref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
    [assembly.step, assembly_parts.csv, base.step, base.stl, cover.step, cover.stl, cover_embossed.step, cover_embossed.stl]
2026-11-09 Updated V2 enclosure plug pockets and shoulder height to fit the WAGO KNX/AUX plugs; revised front legend documentation and renders for 0.6 mm recessed text, unmarked LEDs, and updated V2/V3 labels
    [assembly.step, base.step, base.stl, cover.step, cover.stl, cover_embossed.step, cover_embossed.stl, interface.step]
2026-11-11 Reworked button labels and OLED prompts for left SCROLL/right RESET controls, updated the README and renders, and added screen-width tests. Replaced the TPS2121 core power mux with a leaded superviso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
    [assembly.step, assembly_parts.csv, base.step, base.stl, cover.step, cover.stl, cover_embossed.step, cover_embossed.stl]
2026-11-11 Rotated the v3 XIAO to place its USB-C port at the rail-side board edge, documented plug clearance and routing constraints, and refreshed the board, assembly, and OLED preview images
    [assembly.step, base.step, base.stl, cover.step, cover.stl, interface.kicad_pcb, main.kicad_pcb, main.step]
2026-11-11 Refreshed V2 enclosure and PCB release exports, including STEP models, assembly PDFs, Gerbers, ODB++ archives, and DRC reports
    [assembly.step, base.step, cover.step, cover_embossed.step, interface.step, main.step, panel.kicad_pcb, ui.step]
2026-11-11 Refreshed V2 interface, main, and panel release exports, including STEP models, assembly PDFs, Gerbers, ODB++ archives, and DRC reports
    [interface.step, main.step, panel.kicad_pcb, ui.step]
